penguinmoose/knobOS/img/inside.png

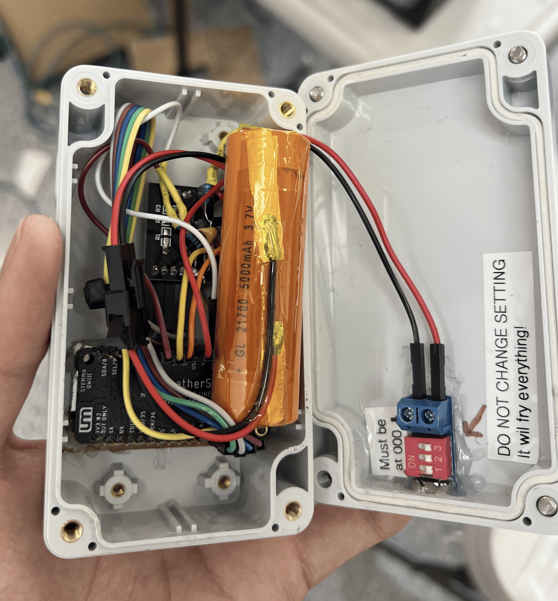
img/inside.png
