penguinmoose/knobOS/img/KnobOS.png

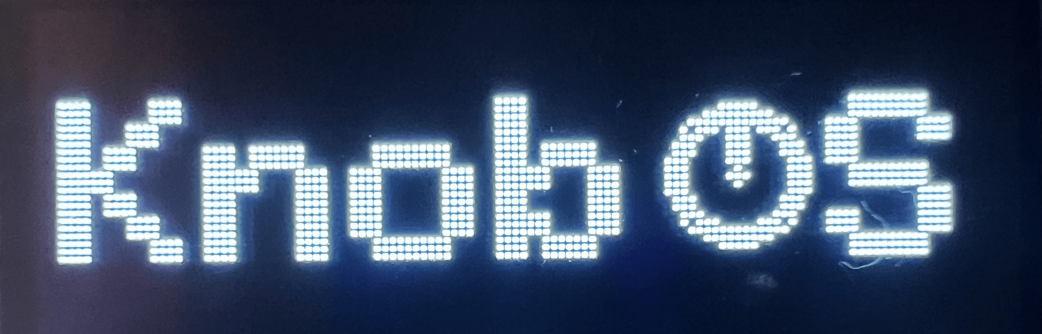
img/KnobOS.png
