penguinmoose/knobOS/img/neopixel-mounting.png

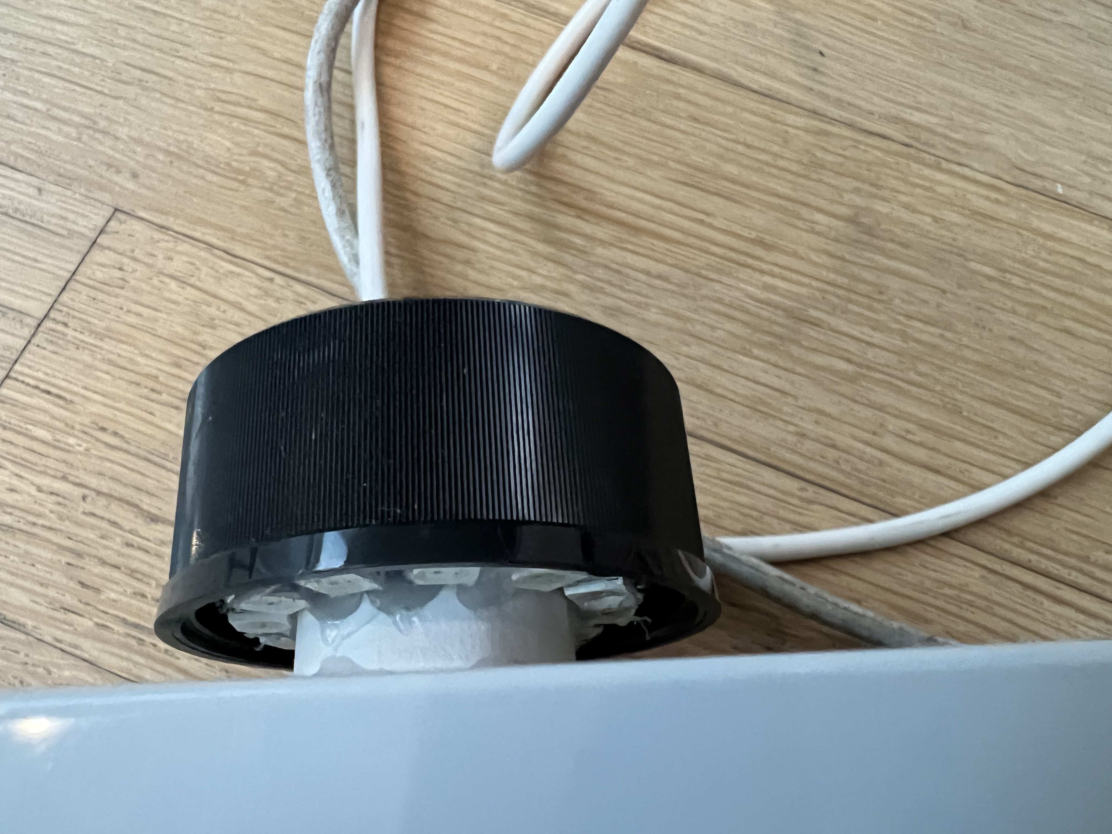
img/neopixel-mounting.png
