penguinmoose/knobOS/knob_os.ino

/* ============================================================================
 *  KNOB OS  --  Unexpected Maker FeatherS2 (ESP32-S2)
 *  + Adafruit 128x64 OLED FeatherWing (SH1107), mounted upside down
 *  + rotary encoder with push-switch (EC11-style)
 *
 *  Home -> Mixer Control
 *       -> Settings -> System Settings
 *                   -> Encoder  -> Encoder Test / Configuration
 *                   -> Wi-Fi    -> Scan / Manual input / Wi-Fi info
 *                   -> Mixer    -> IP, model, tuning
 *                   -> Speaker  -> Scan / Manual IP / Speaker info
 *
 *  BOARD: "UM FeatherS2"  (NOT the Adafruit ESP32-S2 Feather)
 *  LIBS:  Adafruit SH110X, Adafruit GFX, NeoPixel
 * ==========================================================================*/

/* ===========================================================================
 *  KNOB OS  --  version 10.6                        (changelog in CHANGELOG.md)
 *
 *  Major version = a new mini-app or a new subsystem.
 *  Minor version = tweaks, bug fixes, UI work.
 * ========================================================================= */
#define KNOB_OS_VERSION "10.6"

#include <WiFi.h>
#include <WiFiUdp.h>
#include <HTTPClient.h>
#include <stdarg.h>
#include <WiFiClientSecure.h>
#include <WebServer.h>
#include <Wire.h>
#include <Preferences.h>
#include <Adafruit_GFX.h>
#include <Adafruit_SH110X.h>
#include <Adafruit_NeoPixel.h>
#include <esp_sleep.h>
#include <driver/gpio.h>
#include <driver/rtc_io.h>
#include <esp_heap_caps.h>
#include <mbedtls/platform.h>
// Lets npRmtOk() ask whether the NeoPixel pin is still an RMT channel rather
// than trusting a flag; pinMode() elsewhere silently takes it away.
#include <esp32-hal-periman.h>

/* ###########################################################################
 * #                      FORWARD TYPE DECLARATIONS                          #
 * #                                                                         #
 * #  These MUST stay above the first function definition. The Arduino .ino  #
 * #  preprocessor injects auto-generated prototypes just before the first   #
 * #  function, so any type used in a signature has to be declared up here.  #
 * ######################################################################### */

enum Glyph { G_NONE, G_UP, G_DOWN, G_LEFT, G_RIGHT, G_SELECT, G_SELECT_OPEN,
             G_PLAY, G_PAUSE, G_NEXT, G_PREV, G_SPEAKER, G_MUTED, G_SUN,
             G_BACK, G_CHECK_ON, G_CHECK_OFF };

enum BtnId { B_C = 0, B_B = 1, B_A = 2, B_ENC = 3, B_COUNT = 4 };
enum BtnEv { EV_PRESS, EV_REPEAT };

struct App {
  const char *name;
  void (*drawIcon)(int x, int y, int s);
  void (*onEnter)();
  void (*onExit)();
  void (*tick)();
  void (*draw)();
  void (*onButton)(BtnId b, BtnEv e);
  void (*onKnob)(int steps);
  void (*launch)();     // optional prerequisite gate, used instead of a push
  bool (*onBack)();     // return true if the app consumed the back gesture
};

/* Config row kinds. C_LINK/C_ACT are navigation; the rest are editable values.
 * C_CHECK is a bool that toggles on select instead of opening an edit mode --
 * for independent options that are not a choice between alternatives, where a
 * dropdown of two would misrepresent the relationship. */
enum CfgType { C_LINK, C_ACT, C_INT, C_BOOL, C_ENUM, C_INFO, C_CHECK };

struct CfgItem {
  const char *label;
  uint8_t type;
  int32_t *val;
  int32_t lo, hi, step;
  const char *const *opts;
  uint8_t nopts;
  const App *target;
  void (*action)();
  void (*fmt)(char *b, size_t n);   // custom value text, overrides default
  const char *unit;
  /* Both optional and both added after the fact, so they sit at the end: the
   * item tables are positional aggregate initialisers and every existing row
   * leaves these null. */
  const char *(*dynLabel)();        // runtime label, overrides `label`
  bool (*visible)();                // row is hidden while this returns false
};

struct CfgPage {
  const char *title;
  const CfgItem *items;
  uint8_t n;
  uint8_t sel;            // mutable: survives navigating into a submenu
  bool editing;
  const char *(*dynTitle)();
};

struct NvKey { const char *k; int32_t *v; int32_t def; };

// The addresses a single Wi-Fi network carries. Declared up here with the
// other types because the .ino preprocessor puts function prototypes above
// everything, and one of them takes this by reference.
struct NetIps { int32_t mixer; int32_t spk; };

struct TextReq {
  const char *title;
  char *buf;
  uint8_t cap;
  void (*onDone)();
};

/* Each CfgPage repeats its row count as a literal, and forgetting to bump it
 * on adding a row silently hides that row -- a mistake this project has made
 * more than once. Every page declaration is followed by a static_assert that
 * ties the literal to the array, so the next one fails to build instead. */

/* ---- item construction macros (aggregate init must be positional) ------- */
#define ITEM_LINK(l,a)            { l, C_LINK, nullptr,0,0,0, nullptr,0, &a, nullptr, nullptr, nullptr }
#define ITEM_LINKF(l,a,f)         { l, C_LINK, nullptr,0,0,0, nullptr,0, &a, nullptr, f, nullptr }
#define ITEM_ACT(l,fn)            { l, C_ACT,  nullptr,0,0,0, nullptr,0, nullptr, fn, nullptr, nullptr }
#define ITEM_INT(l,v,lo,hi,st,u)  { l, C_INT,  &(v), lo,hi,st, nullptr,0, nullptr,nullptr,nullptr, u }
#define ITEM_BOOL(l,v)            { l, C_BOOL, &(v), 0,1,1, nullptr,0, nullptr,nullptr,nullptr,nullptr }
#define ITEM_ENUM(l,v,o)          { l, C_ENUM, &(v), 0,(int32_t)(sizeof(o)/sizeof(o[0]))-1,1, o,(uint8_t)(sizeof(o)/sizeof(o[0])), nullptr,nullptr,nullptr,nullptr }
#define ITEM_INFO(l,f)            { l, C_INFO, nullptr,0,0,0, nullptr,0, nullptr,nullptr, f, nullptr }
#define ITEM_CHECK(l,v)           { l, C_CHECK,&(v), 0,1,1, nullptr,0, nullptr,nullptr,nullptr,nullptr }
#define ITEM_LINKD(l,a,lf)        { l, C_LINK, nullptr,0,0,0, nullptr,0, &a, nullptr, nullptr, nullptr, lf }
#define ITEM_LINKX(l,a,vis)       { l, C_LINK, nullptr,0,0,0, nullptr,0, &a, nullptr, nullptr, nullptr, nullptr, vis }

/* ###########################################################################
 * #                        FIXED HARDWARE CONFIG                            #
 * #        (things that describe the board, not user preferences)           #
 * ######################################################################### */

/* IP-entry screen state. Declared this early because mixerLaunch, far below,
 * arms the Demo button before the editor's own globals would appear. */
// Defined with the button helpers; used by screens declared before them.
static bool btnSelect(BtnId b);

static bool gIpAllowDemo = false;   // Demo button only offered for the mixer
static int  ipField = 0;            // 0 digits, 1 Demo, 2 Clear
static void (*gIpDemo)() = nullptr;
/* Called whenever the value is written, by either route. Commit and Clear
 * both change the address, so a caller that mirrors it somewhere else has to
 * hear about both -- otherwise clearing an address looks like it worked and
 * comes back on the next lookup. */
static void (*gIpApply)() = nullptr;

/* Rotary encoder. Works with a bare EC11 or with a KY-040 style breakout.
 *
 *   KY-040 pin   ->  here
 *   -----------      ----
 *   CLK          ->  PIN_ENC_A
 *   DT           ->  PIN_ENC_B
 *   SW           ->  PIN_ENC_SW
 *   +            ->  3V3  ** NOT 5V **
 *   GND          ->  GND
 *
 * The + pin may also be left unconnected: every line below is configured
 * INPUT_PULLUP, and the encoder's common contact goes to GND either way. The
 * module's own pull-ups then simply sit unused. Board pull-ups in parallel
 * with the internal ones are harmless -- the result is just a stiffer pull-up.
 *
 * Note some KY-040 clones leave the SW pull-up resistor unpopulated; the
 * internal pull-up covers that case, so SW works regardless.
 *
 * Pin choices worth knowing about:
 *   17/18 are the two DAC outputs. Nothing here uses the DAC, so they are
 *   free -- but if audio output is ever wanted, move CLK/DT elsewhere first.
 *   0 is the BOOT strapping pin. It must be HIGH at reset to boot normally,
 *   which it is: the encoder switch is open when nobody is pressing it and
 *   the internal pull-up holds it high. Holding the shaft button down while
 *   resetting will drop the board into the ROM bootloader instead of running
 *   the sketch -- harmless, and occasionally useful for flashing. */
static const int PIN_ENC_A  = 18;   // CLK  (also DAC2 -- see note below)
static const int PIN_ENC_B  = 17;   // DT   (also DAC1)
static const int PIN_ENC_SW = 0;    // SW   (also the BOOT button)

/* NeoPixel ring, 12 pixels. Pixel 0 sits at 6 o'clock and the index advances
 * clockwise, so a level reads as a gauge sweeping up and around.
 *
 * Wire V+ to BAT, not 3V3: the ring can pull far more than the regulator is
 * meant to source. A 3.3V data line is fine at battery voltage because the
 * WS2812 logic-high threshold is 0.7 x VDD -- about 2.6V at 3.7V, which 3.3V
 * clears easily. */

/* Battery sensing.
 *
 * The plain FeatherS2 has NO on-board battery divider -- unlike the FeatherS2
 * Neo (IO2) and the FeatherS3 (GPIO2), the original board's FAQ states there
 * is no built-in way to read VBAT. So this expects an external divider from
 * BAT to PIN_VBAT, same idea as the 5V sense. Two equal resistors (e.g. two
 * 100k) give a ratio of 2.00; set Batt Ratio to match whatever you fit.
 *
 * PIN_VCHG is the 5V-present sense: a 5.1k:10k divider from the 5V pin gives
 * 5.0 * 10/15.1 = 3.31V, a safe logic high, and 0V when USB is absent. It is
 * an RTC GPIO, so it can also wake the board from deep sleep when a charger
 * is connected. */
static const int PIN_VBAT  = 3;     // external divider from BAT
static const int PIN_VCHG  = 10;    // 5V present, via 5.1k:10k
static const int PIN_NEO   = 7;
static const int NEO_N     = 12;
static const int PIN_BTN_A = 1;    // bottom
static const int PIN_BTN_B = 38;   // middle
static const int PIN_BTN_C = 33;   // top

static const uint8_t OLED_ADDR = 0x3C;
static const int I2C_SDA = 8;
static const int I2C_SCL = 9;

static const int SCREEN_W  = 128;
static const int SCREEN_H  = 64;
static const int CONTENT_W_NARROW = 110;   // leaves room for the label column
static const int CONTENT_W_WIDE   = 126;   // no labels: full width, 2px margin
static int CONTENT_W = CONTENT_W_NARROW;   // reset every frame by loop()
static const int DIVIDER_X = 112;   // nudged right; UI spacing unchanged
static const int LABEL_CX  = 121;          // glyphs span 117..125, 2px margin
// Column geometry: content 0..109, gap 110, divider 111, gap 112..116,
// glyphs 117..125, keep-clear 126..127. The divider-to-glyph gap stays at
// 5px as before; the whole column simply moved right by 3.
static const int LABEL_CY_C = 8, LABEL_CY_B = 32, LABEL_CY_A = 56;

static const int ROW_W    = 106;           // menu row width (scrollbar to right)
static const int ROW_H    = 12;
static const int ROW_TOP  = 14;
static const int ROWS_VIS = 4;
static const int SCROLL_X = 107;

static const uint32_t COMBO_MS   = 18;   // non-chord buttons: debounce only
/* Shortest press that counts as a tap. A release inside the defer window is
 * dispatched at once so a quick tap is not lost, but a contact bounce looks
 * exactly like one -- and dispatching on it delivers the press twice, once
 * there and again when the button settles and the timer expires. A human tap
 * is tens of milliseconds; a bounce is one or two. */
static const uint32_t TAP_MIN_MS = 6;
static const uint32_t DISPLAY_MS = 50;
// Quadrature transitions per mechanical detent on a typical EC11.
static const int ENC_DEFAULT_DIV = 4;

// Protocol timings that have no reason to be user-visible.
static const uint32_t XREMOTE_MS = 4000;
static const uint32_t METER_MS   = 4000;
static const uint32_t RESYNC_MS  = 15000;
static const uint32_t SEND_MIN_MS = 50;
static const float    METER_FLOOR_DB = -60.0f;
static const uint32_t PEAK_HOLD_MS   = 1200;

static const uint32_t WIFI_TIMEOUT_MS = 20000;
static const int      MAX_SAVED_NETS  = 10;

/* ###########################################################################
 * #                    USER SETTINGS  (persisted in NVS)                    #
 * ######################################################################### */

// ---- System --------------------------------------------------------------
static int32_t sysKnobEdit   = 1;   // 0 = edits when merely selected, 1 = only when opened
static int32_t sysStartup    = 0;   // 0 Home, 1 Last app, 2 Last screen
static int32_t sysBackAct    = 0;   // 0 A+B, 1 B+C, 2 A+C, 3 A+B+C
static int32_t sysKnobInvert = 0;
static int32_t sysRepeatDly  = 450;
static int32_t sysRepeatRate = 110;
static int32_t sysComboMs    = 150;  // how long a chord member waits
static int32_t sysStuckSec   = 10;   // ignore a button held this long, 0 = off
static int32_t sysBright     = 200;
static int32_t sysFlip       = 1;   // 1 = rotation 3 (wing mounted inverted)

// ---- Encoder -------------------------------------------------------------
static int32_t encCfgDiv      = ENC_DEFAULT_DIV;  // transitions per detent
static int32_t encCfgInvert   = 0;    // swap if clockwise counts down
static int32_t encCfgAccel    = 1;    // 1 = off, else max multiplier
static int32_t encCfgAccelMs  = 40;   // detents faster than this accelerate
static int32_t encCfgHoldMs   = 2000; // shaft-button hold threshold

// ---- NeoPixel ------------------------------------------------------------
static int32_t npEnable    = 1;
static int32_t npBright    = 60;    // master brightness, applied in software
static int32_t npSmooth    = 1;     // fractional last pixel
static int32_t npOrigin    = 0;     // which physical pixel is the scale start
static int32_t npReverse   = 0;     // flip sweep direction
static int32_t npStep      = 10;    // colour editor coarse step

static int32_t npMxMode    = 1;     // 0 off, 1 fader, 2 meter, 3 auto
/* Auto mode: meter by default, fader when one of these says so. Two
 * independent conditions rather than a choice between them, since wanting the
 * fader while turning and wanting it on a silent channel are unrelated
 * reasons and either, both or neither is a sensible setting. */
static int32_t npMxAutoTurn  = 1;   // show the fader just after a turn
static int32_t npMxAutoQuiet = 1;   // show the fader while nothing is playing
static int32_t npMxAutoHold  = 20;  // how long the turn lasts, x100ms
static int32_t npMxAutoQuiet0 = 10; // silence must last this long, x100ms
static int32_t npMxFadCol  = 0x0080FF;
static int32_t npMxRbCol   = 0xC040FF;
static int32_t npMxZones   = 3;
static int32_t npMxZ1      = 0x00FF00;
static int32_t npMxZ2      = 0xFFA000;
static int32_t npMxZ3      = 0xFF0000;
static int32_t npMxZ4      = 0xFF00FF;
static int32_t npMxT2      = 65;    // % of scale where zone 2 starts
static int32_t npMxT3      = 88;
static int32_t npMxT4      = 97;
static int32_t npMxClip    = 1;     // 0 off, 1 no dim, 2 no dim + full bright
static int32_t npMxEnds    = 1;     // mark 0% / 100% on the fader display
static int32_t npMxWarnCol = 0xFF0000;

static int32_t npSpMode    = 1;     // 0 off, 1 auto, 2 volume, 3 progress
static int32_t npSpCol     = 0x00A0FF;
static int32_t npSpRbCol   = 0xC040FF;   // while the second scrub rate is held
static int32_t npSpEnds    = 1;
static int32_t npSpWarnCol = 0xFF0000;

// ---- Battery and sleep ---------------------------------------------------
static int32_t batSleepMin  = 5;      // idle minutes before sleeping
static int32_t batSleepMode = 0;      // 0 light (all buttons), 1 deep
static int32_t batRatio     = 200;    // divider ratio x100
static int32_t batMv0       = 3300;   // 0%
static int32_t batMv100     = 4200;   // 100%
static int32_t batWarnHi    = 20;     // first warning
static int32_t batWarnLo    = 10;     // second warning
static int32_t batResume    = 5;      // charge to this before normal operation
static int32_t batShowMixer = 1;      // battery readout on the mixer screen
static int32_t batAvgSec    = 20;     // rolling average window
static int32_t batUpdSec    = 5;      // how often the shown value is refreshed
/* Shaft-button action, chosen per app. Mutually exclusive by construction:
 * one action per app, not a set of overlapping toggles. Mute is bound to a
 * hold rather than a click so it cannot be triggered by accident. */
static int32_t encCfgTextBtn  = 0;    // 0 Caps Lock, 1 Confirm, 2 Off

// ---- Mixer ---------------------------------------------------------------
static int32_t mxCfgModel     = 0;    // 0 M32R/X32, 1 X-Air
static int32_t mxCfgIp        = 0;    // packed IPv4, 0 = not set
static int32_t mxCfgPort      = 10023;
static int32_t mxCfgUserHold  = 600;  // ms
static int32_t mxCfgMeterRate = 2;    // 50ms * this
static int32_t mxCfgEncBtn    = 0;    // 0 Hold+Turn strip, 1 Hold=fine, 2 Click, 3 Off
/* Two independent rates, both in 1/1000 of full fader travel per detent.
 * B is simply the rate used while the shaft button is held -- nothing says
 * it has to be the smaller one, so setting B above A turns the hold into a
 * coarse/fast mode instead of a fine one. */
static int32_t mxCfgRateA     = 10;   // 1.0% per detent
static int32_t mxCfgRateB     = 2;    // 0.2% per detent
static int32_t mxCfgAccelOn   = 1;    // 0 off, 1 rate A, 2 rate B, 3 both
static int32_t mxCfgMeterSm   = 55;   // meter release smoothing, %

// ---- Speaker (Sony Audio Control API) ------------------------------------
static int32_t spCfgIp        = 0;     // packed IPv4, 0 = not set
static int32_t spCfgPort      = 10000;
static int32_t spCfgPollMs    = 500;   // volume poll interval
static int32_t spCfgStateMs   = 2500;  // transport-state poll interval
static int32_t spCfgSendMs    = 120;   // min gap between volume writes
static int32_t spCfgUserHold  = 600;
static int32_t spCfgVolMin    = 0;     // knob maps to [VolMin..VolMax], which
static int32_t spCfgVolMax    = 50;    // is a soft range, not a hard stop
// This soundbar's avContent never sees the Spotify Connect stream, so its
// transport verbs do nothing. Mute is local and works, hence the default.
static int32_t spCfgCenterBtn = 0;     // 0 = Auto, 1 = Mute, 2 = Play/Pause
static int32_t spCfgEncBtn    = 0;     // 0 Play/Pause, 1 Mute (hold), 2 Next, 3 Off
/* Which half of Speaker Control leads.
 *
 * All three end up in the same place once the facts are in; they differ only
 * in what is presumed while the first poll is still in flight, which is the
 * couple of seconds the user actually sees. Speaker default presumes a
 * speaker is there and falls back; Spotify default presumes not and switches
 * up when one answers; Spotify only never asks.
 *
 * With addresses now per network, most of the delay this used to cover is
 * gone anyway: on a network with no speaker address there is nothing to
 * presume about, and the app is in Spotify mode from the first frame. */
static int32_t spCfgMode      = 0;     // 0 speaker first, 1 spotify first, 2 spotify only
/* The row under the title is contested: the album wants it, and a long title
 * wants it as a second line. Automatic gives it to whichever needs it. */
static int32_t spCfgTitle     = 2;     // 0 album, 1 wrap, 2 automatic
static int32_t spCfgTitleOver = 1;     // title too long for two lines:
                                       //   0 one marquee row + album, 1 two rows
static int32_t spCfgScrubA    = 5000;  // ms of track per detent
static int32_t spCfgScrubB    = 30000; // ...while the shaft button is held
/* With a speaker the knob belongs to the volume, so seeking has to be asked
 * for: hold the shaft and turn. It gets a rate of its own rather than
 * borrowing Rate B, because it is the only seek rate available in that mode
 * and so wants to sit between a fine and a coarse one rather than being
 * whichever of those Rate B happens to be. 0 disables it. */
static int32_t spCfgScrubHold = 15000; // shaft held while the knob has volume
static int32_t spCfgScrubAcc  = 1;     // 0 off, 1 rate A, 2 rate B, 3 both
static int32_t spCfgBottom    = 0;     // progress block: 0 show, 1 hide
static int32_t spCfgVolHold   = 4;     // seconds the volume overlay lingers
static int32_t spCfgSyPoll    = 4000;  // Spotify metadata poll interval
static int32_t spCfgTransport = 0;     // 0 = Spotify Web, 1 = Sony local, 2 = off
static int32_t spCfgScroll    = 50;    // marquee speed, ms per pixel step
// Cue/review: hold a transport button to scrub through the track.
static int32_t spCfgSeekHold  = 450;   // hold before scrubbing starts, 0 = off
static int32_t spCfgSeekRate  = 15;    // song-seconds per real second
static int32_t spCfgSeekStep  = 100;   // update granularity, ms
static int32_t spCfgSeekAccel = 60;    // %/s speed growth, 0 = constant
static int32_t spCfgTimeRight = 0;     // 0 = remaining, 1 = total duration

// ---- Persisted navigation ------------------------------------------------
static int32_t navSaved0 = -1, navSaved1 = -1, navSaved2 = -1, navSaved3 = -1;

static const NvKey NVKEYS[] = {
  { "sKnobEdit",  &sysKnobEdit,   1   }, { "sStartup",   &sysStartup,    0   },
  { "sBackAct",   &sysBackAct,    0   }, { "sKnobInv",   &sysKnobInvert, 0   },
  { "sRepDly",    &sysRepeatDly,  450 },
  { "sRepRate",   &sysRepeatRate, 110 }, { "sBright",    &sysBright,     200 },
  { "sCombo",     &sysComboMs,    150 }, { "sStuck", &sysStuckSec,  10 },
  { "sFlip",      &sysFlip,       1   },
  { "eDiv",       &encCfgDiv,     ENC_DEFAULT_DIV }, { "eInv", &encCfgInvert, 0 },
  { "eAcc",       &encCfgAccel,   1   }, { "eAccMs",     &encCfgAccelMs, 40  },
  { "eHold",      &encCfgHoldMs,  2000},
  { "npEn",  &npEnable, 1 },      { "npBri",  &npBright, 60 },
  { "npSm",  &npSmooth, 1 },      { "npOrg",  &npOrigin, 0 },
  { "npRev", &npReverse, 0 },     { "npStp",  &npStep,  10 },
  { "npMxM", &npMxMode, 1 },      { "npMxF",  &npMxFadCol, 0x0080FF },
  { "npMxB", &npMxRbCol, 0xC040FF }, { "npMxN", &npMxZones, 3 },
  { "npMxZ1",&npMxZ1, 0x00FF00 }, { "npMxZ2", &npMxZ2, 0xFFA000 },
  { "npMxZ3",&npMxZ3, 0xFF0000 }, { "npMxZ4", &npMxZ4, 0xFF00FF },
  { "npMxT2",&npMxT2, 65 },       { "npMxT3", &npMxT3, 88 },
  { "npMxT4",&npMxT4, 97 },       { "npMxC",  &npMxClip, 1 },
  { "npMxE", &npMxEnds, 1 },      { "npMxW",  &npMxWarnCol, 0xFF0000 },
  { "npMxAT",&npMxAutoTurn, 1 },  { "npMxAQ", &npMxAutoQuiet, 1 },
  { "npMxAH",&npMxAutoHold, 20 }, { "npMxAQD",&npMxAutoQuiet0, 10 },
  { "npSpM", &npSpMode, 1 },      { "npSpC",  &npSpCol, 0x00A0FF },
  { "npSpE", &npSpEnds, 1 },      { "npSpW",  &npSpWarnCol, 0xFF0000 },
  { "npSpB", &npSpRbCol, 0xC040FF },
  { "btSlp", &batSleepMin, 5 },   { "btMode", &batSleepMode, 0 },
  { "btRat", &batRatio, 200 },    { "btMv0",  &batMv0, 3300 },
  { "btMv1", &batMv100, 4200 },   { "btWHi",  &batWarnHi, 20 },
  { "btWLo", &batWarnLo, 10 },    { "btRes",  &batResume, 5 },
  { "btAvg", &batAvgSec, 20 },    { "btUpd",  &batUpdSec, 5 },
  { "btMxS", &batShowMixer, 1 },
  { "mModel",     &mxCfgModel,    0   }, { "mIp",        &mxCfgIp,       0   },
  { "mPort",      &mxCfgPort,     10023}, { "mUserHold",  &mxCfgUserHold, 600 },
  { "mMeterRate", &mxCfgMeterRate,2   }, { "mEncBtn", &mxCfgEncBtn, 0 },
  { "mRateA",     &mxCfgRateA,    10  }, { "mRateB",  &mxCfgRateB,   2 },
  { "mAccelOn",   &mxCfgAccelOn,  1   }, { "mMtrSm", &mxCfgMeterSm, 55 },
  { "pIp",  &spCfgIp,   0    }, { "pPort", &spCfgPort,  10000 },
  { "pPoll",&spCfgPollMs,500  }, { "pState",&spCfgStateMs,2500 },
  { "pSend",&spCfgSendMs,120  }, { "pHold", &spCfgUserHold,600 },
  { "pVMin",&spCfgVolMin,  0  }, { "pVMax", &spCfgVolMax,  50  },
  { "pCtr", &spCfgCenterBtn, 0 }, { "pBot",  &spCfgBottom,    0 },
  { "pEnc", &spCfgEncBtn,    0 }, { "eText", &encCfgTextBtn,  0 },
  { "pVHold",&spCfgVolHold,  4 }, { "pSyP",  &spCfgSyPoll, 4000 },
  { "pTrans",&spCfgTransport,0 }, { "pScrl", &spCfgScroll,   55 },
  { "kHold", &spCfgSeekHold,450 }, { "kRate", &spCfgSeekRate, 15 },
  { "kStep", &spCfgSeekStep,100 }, { "kAccel",&spCfgSeekAccel,60 },
  { "kTimeR",&spCfgTimeRight, 0 },
  { "pMode", &spCfgMode, 0 },     { "kScrA", &spCfgScrubA, 5000 },
  { "pTitle",&spCfgTitle, 2 },    { "pTitleOv", &spCfgTitleOver, 1 },
  { "kScrB", &spCfgScrubB, 30000 }, { "kScrAcc", &spCfgScrubAcc, 1 },
  { "kScrH", &spCfgScrubHold, 15000 },
  { "nav0", &navSaved0, -1 }, { "nav1", &navSaved1, -1 },
  { "nav2", &navSaved2, -1 }, { "nav3", &navSaved3, -1 },
};
static const int NVKEY_N = sizeof(NVKEYS) / sizeof(NVKEYS[0]);

static char wifiSsid[33] = "";
static char wifiPass[65] = "";
static char spName[28]   = "";     // soundbar friendlyName from discovery
static char syClientId[64] = "";
static char sySecret[64]   = "";
char syRefresh[220] = "";   // long-lived; access tokens live in RAM

Preferences prefs;
static bool     nvDirty = false;
static uint32_t nvDirtyMs = 0;

static inline bool elapsed(uint32_t since, uint32_t ms) {
  return (uint32_t)(millis() - since) >= ms;
}

/* Every HTTP call in this firmware blocks, and a blocking call in loop()
 * freezes the knob, the display and the buttons alike. The ESP32-S2 is single
 * core, but FreeRTOS still preempts, and a socket wait yields the CPU, so
 * moving the network work into its own task keeps the UI at full frame rate.
 * The UI only ever sets these flags; netTask does the talking. */
/* Two locks, not one.
 *
 * A single lock meant a Sony request had to wait out whatever Spotify was
 * doing. A TLS handshake or a stalled connect can hold it for seconds, so the
 * speaker's polls timed out on the lock itself and the link looked dead --
 * while the mixer, which talks UDP straight from the UI task and touches
 * neither, carried on working. They use separate client objects, so there was
 * never a reason to serialise them against each other. */
static SemaphoreHandle_t netMutex = nullptr;   // Sony / plain HTTP
static SemaphoreHandle_t syMutex  = nullptr;   // Spotify / TLS
static volatile int      netVolWrite = -1;    // queued volume level
static volatile int      netVolRetry = 0;     // attempts left for that write
/* Two queues, because they belong to two tasks now. netCmd is the LAN side
 * (Sony), syCmd the cloud side (Spotify). */
static volatile uint8_t  netCmd = 0;   // 1 sony next 2 sony prev 3 sony pp 4 mute
static volatile uint8_t  syCmd  = 0;   // 1 next 2 prev 5 play 6 pause 7 seek
static volatile int      netSeekMs = 0;
static volatile bool     syCmdPending = false;   // a Spotify command is in flight
static volatile uint32_t syCmdMs = 0;

// Declared beside the flags so every caller sees it directly.
static void syMarkPending() {
  if (spCfgTransport != 0) return;      // only Spotify commands show this
  syCmdPending = true;
  syCmdMs = millis();
}
static bool syPendingNow() {
  return syCmdPending && !elapsed(syCmdMs, 6000);
}

static volatile bool     netPollVol = false, netPollState = false, netPollSy = false;
static volatile bool     netBusy = false;
static int               netRR = 0;   // round-robin cursor over the polls

// Recursive: syRequest holds it while the 401 path re-enters via the token
// refresh. A plain mutex self-blocks there and wedges the whole task.
static bool netLock() {
  return !netMutex || xSemaphoreTakeRecursive(netMutex, pdMS_TO_TICKS(2500)) == pdTRUE;
}
static void netUnlock() { if (netMutex) xSemaphoreGiveRecursive(netMutex); }

static bool syLock() {
  return !syMutex || xSemaphoreTakeRecursive(syMutex, pdMS_TO_TICKS(15000)) == pdTRUE;
}
static void syUnlock() { if (syMutex) xSemaphoreGiveRecursive(syMutex); }

static void nvLoad() {
  prefs.begin("knobos", true);
  for (int i = 0; i < NVKEY_N; i++)
    *NVKEYS[i].v = prefs.getInt(NVKEYS[i].k, NVKEYS[i].def);
  prefs.getString("wSsid", wifiSsid, sizeof(wifiSsid));
  prefs.getString("wPass", wifiPass, sizeof(wifiPass));
  prefs.getString("spName", spName, sizeof(spName));
  prefs.getString("syId", syClientId, sizeof(syClientId));
  prefs.getString("sySec", sySecret, sizeof(sySecret));
  prefs.getString("syRef", syRefresh, sizeof(syRefresh));
  prefs.end();
}

static void nvFlush() {
  prefs.begin("knobos", false);
  for (int i = 0; i < NVKEY_N; i++) prefs.putInt(NVKEYS[i].k, *NVKEYS[i].v);
  prefs.putString("wSsid", wifiSsid);
  prefs.putString("wPass", wifiPass);
  prefs.putString("spName", spName);
  prefs.putString("syId", syClientId);
  prefs.putString("sySec", sySecret);
  prefs.putString("syRef", syRefresh);
  prefs.end();
  nvDirty = false;
}

// Debounced so a knob sweep across a value doesn't hammer the flash.
static void nvTouch() { nvDirty = true; nvDirtyMs = millis(); }
static void nvService() { if (nvDirty && elapsed(nvDirtyMs, 1500)) nvFlush(); }

static void nvFactoryReset() {
  prefs.begin("knobos", false);
  prefs.clear();
  prefs.end();
  ESP.restart();
}

/* ---- saved network list (unique by SSID, most recent first) -------------- */
static int nvNetCount() {
  prefs.begin("knobos", true);
  int n = prefs.getInt("nNet", 0);
  prefs.end();
  return constrain(n, 0, MAX_SAVED_NETS);
}

static void nvNetGet(int i, char *ssid, size_t sn, char *pass, size_t pn) {
  char ks[8], kp[8];
  snprintf(ks, sizeof(ks), "ns%d", i);
  snprintf(kp, sizeof(kp), "np%d", i);
  prefs.begin("knobos", true);
  prefs.getString(ks, ssid, sn);
  if (pass) prefs.getString(kp, pass, pn);
  prefs.end();
}

/* ---- device addresses per network ----------------------------------------
 *
 * A console lives on one network, and so does a soundbar. Storing one address
 * each meant carrying a venue's mixer IP onto the home network, and the home
 * soundbar's IP everywhere else, where they point at nothing but still read
 * as configured. The mixer app opened, drew a fader and sent OSC into the
 * void; the speaker app offered a volume bar for several seconds before the
 * silence was long enough to prove there was nothing there. Keying both by
 * SSID makes "no mixer here" and "no speaker here" states the device can
 * simply be in, and know instantly.
 *
 * Keyed by SSID rather than by an index into the saved-network list, because
 * that list reorders itself on every connect.
 *
 * mnVer records which fields have been populated from the older single-value
 * settings: 1 = mixer (v10.0), 2 = speaker (v10.4). */
static int nvNetIpsCount() {
  prefs.begin("knobos", true);
  int n = prefs.getInt("mnN", 0);
  prefs.end();
  return constrain(n, 0, MAX_SAVED_NETS);
}

static void nvNetIpsGet(int i, char *ssid, size_t sn, NetIps *out) {
  char ks[8], ki[8], kp[8];
  snprintf(ks, sizeof(ks), "mns%d", i);
  snprintf(ki, sizeof(ki), "mni%d", i);
  snprintf(kp, sizeof(kp), "mnp%d", i);
  prefs.begin("knobos", true);
  if (ssid) prefs.getString(ks, ssid, sn);
  if (out) {
    out->mixer = prefs.getInt(ki, 0);
    out->spk   = prefs.getInt(kp, 0);
  }
  prefs.end();
}

static bool nvNetIpsFind(const char *ssid, NetIps *out) {
  if (out) { out->mixer = 0; out->spk = 0; }
  if (!ssid || !ssid[0]) return false;
  int n = nvNetIpsCount();
  for (int i = 0; i < n; i++) {
    char es[33];
    NetIps v = { 0, 0 };
    es[0] = 0;
    nvNetIpsGet(i, es, sizeof(es), &v);
    if (es[0] && !strcmp(es, ssid)) { if (out) *out = v; return true; }
  }
  return false;
}

/* An address of 0 means "no such device on this network", which is a real
 * answer and worth storing -- otherwise clearing one would silently fall back
 * to whatever the previous single global value happened to be. */
static void nvNetIpsSet(const char *ssid, const NetIps &val) {
  if (!ssid || !ssid[0]) return;
  char s[MAX_SAVED_NETS][33];
  NetIps v[MAX_SAVED_NETS];
  int n = nvNetIpsCount(), out = 0;

  strncpy(s[0], ssid, 32); s[0][32] = 0;
  v[0] = val;
  out = 1;
  for (int i = 0; i < n && out < MAX_SAVED_NETS; i++) {
    char es[33];
    NetIps ev = { 0, 0 };
    es[0] = 0;
    nvNetIpsGet(i, es, sizeof(es), &ev);
    if (!es[0] || !strcmp(es, ssid)) continue;      // dedupe
    strncpy(s[out], es, 32); s[out][32] = 0;
    v[out] = ev;
    out++;
  }

  prefs.begin("knobos", false);
  prefs.putInt("mnN", out);
  for (int i = 0; i < out; i++) {
    char ks[8], ki[8], kp[8];
    snprintf(ks, sizeof(ks), "mns%d", i);
    snprintf(ki, sizeof(ki), "mni%d", i);
    snprintf(kp, sizeof(kp), "mnp%d", i);
    prefs.putString(ks, s[i]);
    prefs.putInt(ki, v[i].mixer);
    prefs.putInt(kp, v[i].spk);
  }
  prefs.end();
}

// Read-modify-write, so setting one address never blanks the other.
static void nvNetSetMixer(const char *ssid, int32_t ip) {
  NetIps v = { 0, 0 };
  nvNetIpsFind(ssid, &v);
  v.mixer = ip;
  nvNetIpsSet(ssid, v);
}
static void nvNetSetSpk(const char *ssid, int32_t ip) {
  NetIps v = { 0, 0 };
  nvNetIpsFind(ssid, &v);
  v.spk = ip;
  nvNetIpsSet(ssid, v);
}

static void nvNetRemember(const char *ssid, const char *pass) {
  if (!ssid[0]) return;
  char s[MAX_SAVED_NETS][33], p[MAX_SAVED_NETS][65];
  int n = nvNetCount(), out = 0;

  strncpy(s[0], ssid, 32); s[0][32] = 0;
  strncpy(p[0], pass, 64); p[0][64] = 0;
  out = 1;
  for (int i = 0; i < n && out < MAX_SAVED_NETS; i++) {
    char es[33], ep[65];
    es[0] = ep[0] = 0;
    nvNetGet(i, es, sizeof(es), ep, sizeof(ep));
    if (!es[0] || !strcmp(es, ssid)) continue;      // dedupe
    strncpy(s[out], es, 32); s[out][32] = 0;
    strncpy(p[out], ep, 64); p[out][64] = 0;
    out++;
  }

  prefs.begin("knobos", false);
  prefs.putInt("nNet", out);
  for (int i = 0; i < out; i++) {
    char ks[8], kp[8];
    snprintf(ks, sizeof(ks), "ns%d", i);
    snprintf(kp, sizeof(kp), "np%d", i);
    prefs.putString(ks, s[i]);
    prefs.putString(kp, p[i]);
  }
  prefs.end();
}

/* ###########################################################################
 * #                    DISPLAY / UI PRIMITIVES                              #
 * ######################################################################### */

Adafruit_SH1107 display = Adafruit_SH1107(64, 128, &Wire);
WiFiUDP udp;

static uint32_t gFrame = 0;   // rendered-frame counter, drives the marquee

static int textW(const char *s) { return (int)strlen(s) * 6; }

// Screens that draw no button-label column can claim the whole panel.
static void uiWide() { CONTENT_W = CONTENT_W_WIDE; }
static int  uiCols() { return CONTENT_W / 6; }

static void printClipped(int x, int y, const char *s, int maxPx) {
  int maxChars = maxPx / 6;
  if (maxChars < 1) return;
  char buf[40];
  if (maxChars > (int)sizeof(buf) - 1) maxChars = sizeof(buf) - 1;
  snprintf(buf, sizeof(buf), "%.*s", maxChars, s);
  display.setCursor(x, y);
  display.print(buf);
}

static void drawGlyph(int cx, int cy, Glyph g, uint16_t col = SH110X_WHITE) {
  const int a = 3, b = 2;
  switch (g) {
    case G_UP:
      display.drawLine(cx - a, cy + b, cx, cy - b, col);
      display.drawLine(cx, cy - b, cx + a, cy + b, col);
      break;
    case G_DOWN:
      display.drawLine(cx - a, cy - b, cx, cy + b, col);
      display.drawLine(cx, cy + b, cx + a, cy - b, col);
      break;
    case G_LEFT:
      display.drawLine(cx + b, cy - a, cx - b, cy, col);
      display.drawLine(cx - b, cy, cx + b, cy + a, col);
      break;
    case G_RIGHT:
      display.drawLine(cx - b, cy - a, cx + b, cy, col);
      display.drawLine(cx + b, cy, cx - b, cy + a, col);
      break;
    case G_SELECT:      display.fillCircle(cx, cy, 3, col); break;
    case G_SELECT_OPEN: display.drawCircle(cx, cy, 3, col); break;
    /* A return arrow, not a left chevron. "<" is the same shape this UI uses
     * for "move left", so on a screen where the bottom button leaves rather
     * than moves it read as a direction instead of an action. */
    case G_BACK:
      display.drawFastHLine(cx - 3, cy + 1, 7, col);
      display.drawFastVLine(cx + 3, cy - 3, 5, col);
      display.drawLine(cx - 3, cy + 1, cx, cy - 2, col);
      display.drawLine(cx - 3, cy + 1, cx, cy + 4, col);
      break;
    case G_CHECK_OFF:
      display.drawRect(cx - 4, cy - 4, 9, 9, col);
      break;
    case G_CHECK_ON:
      display.drawRect(cx - 4, cy - 4, 9, 9, col);
      display.drawLine(cx - 2, cy, cx - 1, cy + 2, col);
      display.drawLine(cx - 1, cy + 2, cx + 2, cy - 2, col);
      display.drawLine(cx - 2, cy + 1, cx - 1, cy + 3, col);
      display.drawLine(cx - 1, cy + 3, cx + 2, cy - 1, col);
      break;
    case G_PLAY:
      display.fillTriangle(cx - 3, cy - 4, cx - 3, cy + 4, cx + 4, cy, col);
      break;
    case G_PAUSE:
      display.fillRect(cx - 3, cy - 4, 2, 9, col);
      display.fillRect(cx + 1, cy - 4, 2, 9, col);
      break;
    case G_NEXT:
      display.fillTriangle(cx - 4, cy - 4, cx - 4, cy + 4, cx + 1, cy, col);
      display.fillRect(cx + 2, cy - 4, 2, 9, col);
      break;
    case G_PREV:
      display.fillRect(cx - 4, cy - 4, 2, 9, col);
      display.fillTriangle(cx + 3, cy - 4, cx + 3, cy + 4, cx - 2, cy, col);
      break;
    case G_SUN: {
      display.fillCircle(cx, cy, 2, col);
      for (int a = 0; a < 8; a++) {
        float t = a * PI / 4.0f;
        int x1 = cx + (int)lroundf(cosf(t) * 4), y1 = cy + (int)lroundf(sinf(t) * 4);
        int x2 = cx + (int)lroundf(cosf(t) * 5), y2 = cy + (int)lroundf(sinf(t) * 5);
        display.drawLine(x1, y1, x2, y2, col);
      }
      break;
    }
    case G_SPEAKER:
    case G_MUTED:
      display.fillRect(cx - 4, cy - 2, 3, 5, col);
      display.fillTriangle(cx - 1, cy - 4, cx - 1, cy + 4, cx + 2, cy, col);
      if (g == G_MUTED) display.drawLine(cx - 4, cy + 4, cx + 4, cy - 4, col);
      else { display.drawFastVLine(cx + 4, cy - 2, 5, col); }
      break;
    default: break;
  }
}

static void drawButtonLabels(Glyph c, Glyph b, Glyph a) {
  display.drawFastVLine(DIVIDER_X, 0, SCREEN_H, SH110X_WHITE);
  drawGlyph(LABEL_CX, LABEL_CY_C, c);
  drawGlyph(LABEL_CX, LABEL_CY_B, b);
  drawGlyph(LABEL_CX, LABEL_CY_A, a);
}

static void drawBar(int x, int y, int w, int h, float frac) {
  display.drawRect(x, y, w, h, SH110X_WHITE);
  int f = (int)(constrain(frac, 0.0f, 1.0f) * (w - 2));
  if (f > 0) display.fillRect(x + 1, y + 1, f, h - 2, SH110X_WHITE);
}

static void drawTitle(const char *t) {
  display.setTextSize(1);
  display.setTextColor(SH110X_WHITE);
  printClipped(0, 0, t, CONTENT_W);
  display.drawFastHLine(0, 10, CONTENT_W, SH110X_WHITE);
}

static void drawCentered(int y, const char *s) {
  int x = (CONTENT_W - textW(s)) / 2;
  printClipped(x < 0 ? 0 : x, y, s, CONTENT_W);
}

static void drawScrollbar(int n, int first) {
  if (n <= ROWS_VIS) return;
  int h = ROWS_VIS * ROW_H;
  display.drawRect(SCROLL_X, ROW_TOP, 3, h, SH110X_WHITE);
  int th = max(4, h * ROWS_VIS / n);
  int ty = ROW_TOP + (h - th) * first / (n - ROWS_VIS);
  display.fillRect(SCROLL_X, ty, 3, th, SH110X_WHITE);
}

/* A menu row.
 *   selected + not editing -> whole row inverted
 *   selected + editing     -> row inverted, value re-inverted inside a chip,
 *                             so the field being changed reads as "open"     */
static void drawRow(int y, bool sel, bool editing, const char *label,
                    const char *value, Glyph tail) {
  if (sel) display.fillRect(0, y, ROW_W, ROW_H - 1, SH110X_WHITE);
  uint16_t fg = sel ? SH110X_BLACK : SH110X_WHITE;
  display.setTextColor(fg);

  int vw = value ? textW(value) : 0;
  int tailW = (tail != G_NONE) ? 9 : 0;
  int vx = ROW_W - 3 - vw - tailW;

  printClipped(3, y + 2, label, vx - 5);

  if (value && vw) {
    if (editing) {
      display.fillRect(vx - 2, y, vw + 4, ROW_H - 1, SH110X_BLACK);
      display.setTextColor(SH110X_WHITE);
    }
    display.setCursor(vx, y + 2);
    display.print(value);
    display.setTextColor(fg);
  }
  if (tail != G_NONE) drawGlyph(ROW_W - 6, y + ROW_H / 2 - 1, tail, fg);
  display.setTextColor(SH110X_WHITE);
}

/* ###########################################################################
 * #                       BATTERY AND SLEEP                                 #
 * #                                                                         #
 * #  Wake-source constraint worth knowing: on the ESP32-S2 only GPIO0..21   #
 * #  are RTC-capable, and deep sleep can only be woken by those. Buttons B  #
 * #  (38) and C (33) are outside that range, so they physically cannot wake #
 * #  the chip from deep sleep. Light sleep has no such limit -- any GPIO    #
 * #  can wake it -- at the cost of a few hundred microamps instead of tens. #
 * #  Light is therefore the default, since all four buttons work and the    #
 * #  screen resumes exactly where it was; Deep is offered for long storage. #
 * ######################################################################### */

RTC_DATA_ATTR static int  rtcWokeEmpty = 0;   // slept because the pack was flat
RTC_DATA_ATTR static int  rtcGoHome    = 0;   // slept from the sleep menu

static bool     gExtMalloc = false;   // did a large malloc land in PSRAM?
static volatile bool gSyBusy = false; // a Spotify request is in flight

/* ---- mbedTLS allocator: the actual cause of "connect -1 blk 34xxx" -------
 *
 * Every PSRAM measure since v8.8 was aimed at the wrong pool. The Arduino
 * core ships CONFIG_MBEDTLS_INTERNAL_MEM_ALLOC=y, which pins EVERY mbedTLS
 * allocation to MALLOC_CAP_INTERNAL. So ps_malloc for our own buffers, and
 * heap_caps_malloc_extmem_enable() for the general allocator, could never
 * reach it: mbedTLS does not use the general allocator at all.
 *
 * And it is asking for a lot. CONFIG_MBEDTLS_SSL_MAX_CONTENT_LEN is 16384
 * with CONFIG_MBEDTLS_ASYMMETRIC_CONTENT_LEN switched OFF, so a handshake
 * allocates BOTH record buffers at full size -- roughly 16.5KB each, ~33KB
 * together, and the certificate chain on top of that. ESP.getMaxAllocHeap()
 * reports the largest free INTERNAL block, which is the very pool in
 * question, and on this board it reads 32-38KB. That is why the number in
 * the error message sat just above the guard and the handshake still failed:
 * the first buffer fits, the second only just, and the chain parse does not.
 * A figure that hovers on the boundary is also why this was intermittent for
 * so long and why every timeout, retry and task change moved it slightly.
 *
 * mbedTLS record buffers are never touched by DMA -- lwIP copies into them --
 * so external RAM is a perfectly valid home for them. That is exactly what
 * CONFIG_MBEDTLS_EXTERNAL_MEM_ALLOC does, and since a stock Arduino install
 * cannot change sdkconfig, the same thing is done at runtime here.
 *
 * Only blocks at or above TLS_PS_MIN are moved. Small, frequent crypto
 * allocations stay in fast internal RAM, so this is narrower than the global
 * extmem redirect reverted in v9.7 -- and unlike that one it cannot touch the
 * Wi-Fi driver's DMA buffers, because those never come through mbedTLS. */
static const size_t TLS_PS_MIN = 1024;
static bool gTlsPsram = false;        // mbedTLS allocations redirected to PSRAM

static void *tlsPsCalloc(size_t n, size_t sz) {
  if (sz && n > (SIZE_MAX / sz)) return nullptr;
  if (n * sz >= TLS_PS_MIN) {
    void *p = heap_caps_calloc(n, sz, MALLOC_CAP_SPIRAM | MALLOC_CAP_8BIT);
    if (p) return p;                  // fall through to internal if PSRAM is full
  }
  return heap_caps_calloc(n, sz, MALLOC_CAP_INTERNAL | MALLOC_CAP_8BIT);
}
static void tlsPsFree(void *p) { heap_caps_free(p); }

/* Must run before anything does crypto -- the Wi-Fi supplicant included --
 * so this is called at the very top of setup(). */
static void tlsHeapInit() {
  if (!psramFound()) return;
  gTlsPsram = (mbedtls_platform_set_calloc_free(tlsPsCalloc, tlsPsFree) == 0);
}

/* Modem power save is on by default. It parks the radio between DTIM beacons,
 * which costs little on a strong link but on a weak one turns into dropped
 * packets and long retransmits -- and a TLS handshake is a long chain of
 * small round trips, so it fails where a single tiny LAN request still gets
 * through. That asymmetry is exactly the "speaker works, Spotify does not"
 * pattern at -80 dBm. */
static void wifiTune() {
  /* Power save off is a genuine reliability win on a marginal link. Forcing
   * maximum TX power is not: it raises the current spike during transmit,
   * and on battery a sag mid-handshake looks exactly like a refused
   * connection. It was not set when this last worked, so it is left at the
   * driver's default. */
  WiFi.setSleep(false);
}
static float    batMvEma = -1.0f;
static uint32_t batLastRead = 0;
static uint32_t gLastActivity = 0;
static bool     gWakeGuard = false;   // ignore buttons until all are released
static int      batWarned = 0;        // 0 none, 1 high warning, 2 low warning
static bool     batChargeWait = false;

static bool batCharging() { return digitalRead(PIN_VCHG) == HIGH; }

/* Two separate time constants, because they solve different halves of the
 * jitter. The rolling average smooths ADC and load noise; the latch stops the
 * displayed number twitching even when the average moves slightly. Without
 * the latch a slow average still flickers between two adjacent percentages. */
static const uint32_t BAT_SAMPLE_MS = 250;
static float    batShownMv = -1.0f;
static uint32_t batLastUpd = 0;

static int batMv() {
  if (batMvEma < 0.0f || elapsed(batLastRead, BAT_SAMPLE_MS)) {
    batLastRead = millis();
    uint32_t acc = 0;
    for (int i = 0; i < 8; i++) acc += analogReadMilliVolts(PIN_VBAT);
    float mv = (acc / 8.0f) * ((float)batRatio / 100.0f);
    if (batMvEma < 0.0f) { batMvEma = mv; batShownMv = mv; }
    else {
      // Exponential average whose time constant is the configured window.
      float n = max(1.0f, (float)batAvgSec * 1000.0f / BAT_SAMPLE_MS);
      batMvEma += (mv - batMvEma) / n;
    }
  }
  if (batShownMv < 0.0f || elapsed(batLastUpd, (uint32_t)max((int)batUpdSec, 1) * 1000UL)) {
    batLastUpd = millis();
    batShownMv = batMvEma;
  }
  return (int)lroundf(batShownMv);
}

/* Linear between the configured endpoints. A LiPo's discharge curve is not
 * linear, but the flat middle means any simple mapping is approximate; the
 * endpoints are configurable so the reading can be trimmed to the pack. */
static int batSoc() {
  int span = max(1, (int)(batMv100 - batMv0));
  return constrain((batMv() - (int)batMv0) * 100 / span, 0, 100);
}

static void batNoteActivity() { gLastActivity = millis(); }

/* Battery glyph. Five fill states plus a bolt when 5V is present. */
/* Lightning bolt, drawn to the LEFT of the battery rather than inside it:
 * at scale 1 the body is only 5px tall, and a bolt inked into that is not
 * legible. */
static void drawBolt(int x, int y, int scale) {
  int u = scale;
  display.fillTriangle(x + 3*u, y, x, y + 5*u, x + 3*u, y + 5*u, SH110X_WHITE);
  display.fillTriangle(x + 2*u, y + 9*u, x + 5*u, y + 4*u, x + 2*u, y + 4*u, SH110X_WHITE);
}

static void drawBattery(int x, int y, int soc, int scale) {
  // 14 wide rather than 13: at 13 the first bar sat against the border and
  // read as part of it, so two bars looked like one.
  int w = 14 * scale, h = 7 * scale;
  display.drawRect(x, y, w, h, SH110X_WHITE);
  display.fillRect(x + w, y + 2 * scale, scale, h - 4 * scale, SH110X_WHITE);

  int bars = (soc >= 88) ? 4 : (soc >= 63) ? 3 : (soc >= 38) ? 2 : (soc >= 13) ? 1 : 0;
  for (int i = 0; i < bars; i++)
    display.fillRect(x + 2 * scale + i * 3 * scale, y + scale, 2 * scale,
                     h - 2 * scale, SH110X_WHITE);
  if (!bars && soc > 0)   // nearly empty: a sliver rather than nothing
    display.fillRect(x + 2 * scale, y + scale, scale, h - 2 * scale, SH110X_WHITE);
}

// Icon plus percentage, right-aligned so it sits neatly in a corner.
static void drawBatteryStatus(int rightX, int y, int scale) {
  int soc = batSoc();
  bool chg = batCharging();
  char t[8];
  snprintf(t, sizeof(t), "%d%%", soc);
  int tw = (int)strlen(t) * 6 * scale;
  int bw = 15 * scale;              // body plus the terminal nub
  int boltW = chg ? (6 * scale) : 0;   // 1px tighter to pay for the wider body
  int x = rightX - (boltW + bw + 3 + tw);
  if (chg) drawBolt(x - 1, y - scale, scale);   // 1px left, clears the body
  drawBattery(x + boltW, y, soc, scale);
  display.setTextSize(scale);
  display.setCursor(x + boltW + bw + 3, y);
  display.print(t);
  display.setTextSize(1);
}

/* ---- sleep ------------------------------------------------------------- */
static void sleepPrepare() {
  npClear();
  /* Clearing sends zeros, but once the CPU sleeps GPIO7 stops being driven
   * and a floating WS2812 data line can latch noise into the pixels -- which
   * on a ring powered straight from BAT means it keeps draining. Drive the
   * line low and latch that state so it survives sleep. The short delay lets
   * the clear frame plus its reset gap finish first. */
  delay(5);
  pinMode(PIN_NEO, OUTPUT);
  digitalWrite(PIN_NEO, LOW);
  gpio_hold_en((gpio_num_t)PIN_NEO);
  gpio_deep_sleep_hold_en();
  display.clearDisplay();
  display.display();
  display.oled_command(SH110X_DISPLAYOFF);
}

static void sleepResume() {
  gpio_hold_dis((gpio_num_t)PIN_NEO);
  gpio_deep_sleep_hold_dis();
  display.oled_command(SH110X_DISPLAYON);
  gWakeGuard = true;             // the wake press must not also act
  knobResetSteps();
  batNoteActivity();
}

/* Nothing may be held when sleep begins.
 *
 * Both wake sources are LEVEL triggered, not edge: a button that is still
 * down when the CPU stops is not a press waiting to happen, it is the wake
 * condition already true. Deep sleep waited for the shaft button because that
 * is its only wake pin; light sleep arms all four and waited for none of
 * them, so holding the select button a moment too long woke the device on the
 * instant it slept. The wake guard could not help -- the device was awake and
 * correctly ignoring the button, which is a different problem from never
 * having slept.
 *
 * The cap exists so a genuinely stuck button cannot block sleep forever; it
 * will wake straight back up, which is the honest outcome. */
static void sleepWaitRelease(const int *pins, int n) {
  uint32_t t0 = millis();
  for (;;) {
    bool held = false;
    for (int i = 0; i < n; i++) if (digitalRead(pins[i]) == LOW) held = true;
    if (!held || millis() - t0 > 5000) break;
    delay(10);
  }
  delay(60);                          // let the contact settle
}

static void enterSleep(bool fromMenu, bool forceDeep = false) {
  rtcGoHome = fromMenu ? 1 : 0;
  navSaveNow();
  nvFlush();
  sleepPrepare();

  if (batSleepMode == 0 && !forceDeep) {
    /* Light sleep: every button can wake it because GPIO wake is not limited
     * to RTC pins. Wi-Fi is stopped first, otherwise the radio keeps waking
     * the CPU for beacons and the saving is largely undone. */
    WiFi.disconnect(true);
    WiFi.mode(WIFI_OFF);
    const int pins[4] = { PIN_BTN_A, PIN_BTN_B, PIN_BTN_C, PIN_ENC_SW };
    sleepWaitRelease(pins, 4);        // all four wake it, so all four must be up
    for (int i = 0; i < 4; i++)
      gpio_wakeup_enable((gpio_num_t)pins[i], GPIO_INTR_LOW_LEVEL);
    esp_sleep_enable_gpio_wakeup();
    esp_light_sleep_start();

    WiFi.mode(WIFI_STA);
    if (wifiConfigured()) { WiFi.begin(wifiSsid, wifiPass); wifiTune(); }
    sleepResume();
    if (fromMenu) navHome();
    return;
  }

  /* Deep sleep: ext0 takes a single RTC pin, so the shaft button is the wake
   * key. B and C are not RTC-capable and cannot serve here.
   *
   * Two things have to be right or it wakes immediately. The normal GPIO
   * pull-up is switched off when the digital domain powers down, so the pin
   * floats and reads LOW -- which is exactly the wake condition. The RTC
   * pull-up has to be enabled instead. And the button that selected "Off" is
   * still down at this point, so wait for it to come up first. */
  rtc_gpio_pullup_en((gpio_num_t)PIN_ENC_SW);
  rtc_gpio_pulldown_dis((gpio_num_t)PIN_ENC_SW);
  const int deepPin[1] = { PIN_ENC_SW };
  sleepWaitRelease(deepPin, 1);       // ext0 is the shaft button alone
  esp_sleep_enable_ext0_wakeup((gpio_num_t)PIN_ENC_SW, 0);
  esp_deep_sleep_start();
}

/* Flat battery. Sleep with the charger line as the only wake source.
 *
 * Polling on a timer to re-check the level would spend energy from an already
 * empty pack, and could not change the outcome anyway: nothing but a charger
 * raises the charge. Waking on the charger line costs nothing while asleep
 * and fires exactly when something can actually be done. */
static void enterEmptySleep() {
  rtcWokeEmpty = 1;
  navSaveNow();
  nvFlush();
  sleepPrepare();
  // Same reasoning in reverse: hold the charge-sense line down so a floating
  // input cannot look like "charger connected".
  rtc_gpio_pulldown_en((gpio_num_t)PIN_VCHG);
  rtc_gpio_pullup_dis((gpio_num_t)PIN_VCHG);
  esp_sleep_enable_ext1_wakeup(1ULL << PIN_VCHG, ESP_EXT1_WAKEUP_ANY_HIGH);
  esp_deep_sleep_start();
}

/* ###########################################################################
 * #                        NEOPIXEL RING                                    #
 * #                                                                         #
 * #  A 12-pixel ring used as a gauge. Pixel 0 is at 6 o'clock and the index #
 * #  runs clockwise, so a level sweeps up and around like a dial.           #
 * #                                                                         #
 * #  Brightness is applied in software rather than through the library's    #
 * #  setBrightness(), because the clip indicator has to be able to ignore   #
 * #  the master level entirely -- a clip you might miss is not a clip       #
 * #  indicator.                                                             #
 * ######################################################################### */

static Adafruit_NeoPixel ring(NEO_N, PIN_NEO, NEO_GRB + NEO_KHZ800);
static uint8_t npBuf[NEO_N][3];
static bool    npTouched = false;   // did anything draw this frame?
static bool    npLit = false;       // is anything currently lit?

static inline uint8_t npR(int32_t c) { return (uint8_t)((c >> 16) & 0xFF); }
static inline uint8_t npG(int32_t c) { return (uint8_t)((c >> 8) & 0xFF); }
static inline uint8_t npB(int32_t c) { return (uint8_t)(c & 0xFF); }
static inline int32_t npRGB(int r, int g, int b) {
  return ((int32_t)(r & 0xFF) << 16) | ((int32_t)(g & 0xFF) << 8) | (b & 0xFF);
}

/* ---- claiming the RMT channel ourselves ---------------------------------
 *
 * The ring failing to start on some boots and coming right after a reset is
 * a stuck semaphore inside the library.
 *
 * Adafruit_NeoPixel's ESP-IDF 5 backend takes a mutex around every show().
 * On one path -- rmtInit() failing -- it returns WITHOUT giving that mutex
 * back. Every later show() then times out on it and does nothing, silently,
 * for the rest of the session. A ring that is dead until the next boot is
 * exactly what that produces. (There is a second, quieter one: the mutex is
 * created once from a global constructor and never retried, and if that
 * allocation failed show() would be a no-op forever.)
 *
 * So the channel is claimed here, before the library ever asks for it.
 * rmtInit() returns true immediately when the pin is already a TX channel at
 * the same frequency and block size, so once this succeeds the library's own
 * call becomes a no-op that cannot fail and cannot strand anything. The
 * parameters must match its call exactly (10MHz, one memory block) or it
 * will tear this down and build its own.
 *
 * Re-checked rather than latched: pinMode() detaches the channel through the
 * peripheral manager, and sleepPrepare() parks the data line that way before
 * every sleep. */
static bool     npRmtReady = false;
static uint32_t npRmtTry = 0;

static bool npRmtOk() {
  if (npRmtReady && perimanGetPinBusType(PIN_NEO) == ESP32_BUS_TYPE_RMT_TX)
    return true;
  /* Either it was never claimed or something detached it. Re-claim at once in
   * the second case; rate-limit the first, so hardware that is genuinely
   * refusing is not asked twenty times a second. */
  if (npRmtReady || elapsed(npRmtTry, 500)) {
    npRmtTry = millis();
    npRmtReady = rmtInit(PIN_NEO, RMT_TX_MODE, RMT_MEM_NUM_BLOCKS_1, 10000000);
    return npRmtReady;
  }
  npRmtReady = false;
  return false;
}

static void npBegin() {
  // Release any pad hold left over from a previous deep sleep.
  gpio_deep_sleep_hold_dis();
  gpio_hold_dis((gpio_num_t)PIN_NEO);
  /* Retry the library's own mutex. It is created from a global constructor
   * and never attempted again, so a single failure there would be permanent. */
  espInit();
  ring.begin();                     // pinMode() first: it would detach the RMT
  ring.setBrightness(255);          // scaling is done per pixel below
  /* A few attempts before giving up on the claim, since the boot-time failure
   * this is here to fix is intermittent rather than absolute. npRmtOk() keeps
   * trying afterwards regardless, so a ring that misses its start now comes
   * up on its own instead of waiting for a reset. */
  /* Claimed directly rather than through npRmtOk(), whose rate limit is
   * measured against millis() -- which is still small this early and would
   * refuse the retries. */
  for (int i = 0; i < 5 && !npRmtReady; i++) {
    npRmtReady = rmtInit(PIN_NEO, RMT_TX_MODE, RMT_MEM_NUM_BLOCKS_1, 10000000);
    if (!npRmtReady) delay(20);
  }
  npRmtTry = millis();
  ring.clear();
  if (npRmtReady) ring.show();
  /* If the pixel buffer is null the library's malloc failed and nothing will
   * ever light, which is otherwise indistinguishable from a wiring fault. */
  Serial.printf("[np] pin=%d n=%d buf=%s rmt=%s\n", PIN_NEO, NEO_N,
                ring.getPixels() ? "ok" : "NULL", npRmtReady ? "ok" : "FAIL");
}

static void npFrameStart() { memset(npBuf, 0, sizeof(npBuf)); npTouched = true; }

/* Map a logical scale position onto a physical pixel, honouring the origin
 * offset and direction so the ring can be mounted any way round. */
static int npMap(int i) {
  int n = NEO_N;
  int k = npReverse ? (n - 1 - i) : i;
  k += (int)npOrigin;
  k %= n;
  if (k < 0) k += n;
  return k;
}

// level 0..1 of this pixel's own contribution, colour scaled by it
static void npSet(int i, int32_t col, float level, bool ignoreMaster) {
  if (i < 0 || i >= NEO_N) return;
  level = constrain(level, 0.0f, 1.0f);
  float m = ignoreMaster ? 1.0f : (float)constrain(npBright, 1, 255) / 255.0f;
  float f = level * m;
  int p = npMap(i);
  npBuf[p][0] = (uint8_t)lroundf(npR(col) * f);
  npBuf[p][1] = (uint8_t)lroundf(npG(col) * f);
  npBuf[p][2] = (uint8_t)lroundf(npB(col) * f);
}

/* Push to the ring only when something actually changed, and never faster
 * than the display refresh. show() was previously called on every loop pass
 * -- several hundred times a second -- which achieves nothing visible and
 * keeps the RMT peripheral busy for ~360us each time. */
static uint8_t  npSent[NEO_N][3];
static uint32_t npLastShow = 0;

static void npFrameEnd() {
  if (!npEnable || !npRmtOk()) return;
  bool changed = memcmp(npSent, npBuf, sizeof(npBuf)) != 0;
  if (!changed || !elapsed(npLastShow, DISPLAY_MS)) { npLit = true; return; }
  npLastShow = millis();
  memcpy(npSent, npBuf, sizeof(npBuf));
  for (int i = 0; i < NEO_N; i++)
    ring.setPixelColor(i, ring.Color(npBuf[i][0], npBuf[i][1], npBuf[i][2]));
  ring.show();
  npLit = true;
}

static void npClear() {
  if (!npLit) return;
  if (!npRmtOk()) { npLit = false; return; }
  ring.clear();
  ring.show();
  memset(npSent, 0, sizeof(npSent));
  npLastShow = millis();
  npLit = false;
}

/* Colour for a pixel sitting at position `pos` (0..1) along a zoned scale.
 * Zones are chosen by where the PIXEL is, not by the current level, which is
 * what makes it read like a console meter rather than a colour-changing bar. */
static int32_t npZoneAt(float pos) {
  int zones = constrain((int)npMxZones, 2, 4);
  /* Nothing stops the thresholds being edited out of order, and if t3 fell
   * below t2 the zones would swap over. Order them here so a bad setting
   * degrades to a sensible meter instead of a scrambled one. */
  float t2 = npMxT2 / 100.0f;
  float t3 = max(t2, npMxT3 / 100.0f);
  float t4 = max(t3, npMxT4 / 100.0f);
  if (zones >= 4 && pos >= t4) return npMxZ4;
  if (zones >= 3 && pos >= t3) return npMxZ3;
  if (pos >= t2) return npMxZ2;
  return npMxZ1;
}

/* Draw a level as a scale.
 *
 * With smoothing on, the pixel straddling the level is lit proportionally to
 * how far into it the level reaches, so the ring reads as continuous rather
 * than as twelve discrete steps -- the same idea as anti-aliasing a line.  */
static void npScale(float frac, int32_t flatCol, bool zoned,
                    bool endsWarn, int32_t warnCol,
                    bool clipPix, bool clipFull) {
  frac = constrain(frac, 0.0f, 1.0f);
  float lit = frac * NEO_N;

  for (int i = 0; i < NEO_N; i++) {
    float level;
    if (lit >= (float)(i + 1))      level = 1.0f;
    else if (lit <= (float)i)       level = 0.0f;
    else                            level = npSmooth ? (lit - (float)i) : 1.0f;
    if (level <= 0.0f) continue;

    int32_t col = zoned ? npZoneAt(((float)i + 0.5f) / NEO_N) : flatCol;

    // Ends only turn warning-coloured at the actual extremes, so the ring
    // does not permanently look like it is complaining.
    if (endsWarn && i == 0 && frac <= 0.0005f)          col = warnCol;
    if (endsWarn && i == NEO_N - 1 && frac >= 0.9995f)  col = warnCol;

    bool isClip = clipPix && (i == NEO_N - 1);
    if (isClip) npSet(i, col, 1.0f, clipFull);   // never dimmed by level
    else        npSet(i, col, level, false);
  }

  /* At zero the loop above lights nothing, so the "at minimum" marker would
   * never appear. Light it explicitly -- that state is exactly the one worth
   * flagging. */
  if (endsWarn && frac <= 0.0005f) npSet(0, warnCol, 1.0f, false);

  // A clip pixel that is armed but not reached stays dark; once reached it is
  // full-on regardless of smoothing or master brightness.
  if (clipPix && frac > (float)(NEO_N - 1) / NEO_N) {
    int32_t col = zoned ? npZoneAt(1.0f) : flatCol;
    npSet(NEO_N - 1, col, 1.0f, clipFull);
  }
}

/* ---- HSV <-> RGB, for the colour editor -------------------------------- */
static void npToHSV(int32_t c, int *h, int *sv, int *v) {
  float r = npR(c) / 255.0f, g = npG(c) / 255.0f, b = npB(c) / 255.0f;
  float mx = max(r, max(g, b)), mn = min(r, min(g, b));
  float d = mx - mn;
  float hh = 0.0f;
  if (d > 0.0001f) {
    if (mx == r)      hh = 60.0f * fmodf((g - b) / d, 6.0f);
    else if (mx == g) hh = 60.0f * (((b - r) / d) + 2.0f);
    else              hh = 60.0f * (((r - g) / d) + 4.0f);
  }
  if (hh < 0) hh += 360.0f;
  *h  = (int)lroundf(hh) % 360;
  *sv = (int)lroundf((mx <= 0.0001f ? 0.0f : d / mx) * 100.0f);
  *v  = (int)lroundf(mx * 100.0f);
}

static int32_t npFromHSV(int h, int sv, int v) {
  float S = constrain(sv, 0, 100) / 100.0f;
  float V = constrain(v, 0, 100) / 100.0f;
  float H = (float)(((h % 360) + 360) % 360) / 60.0f;
  float C = V * S;
  float X = C * (1.0f - fabsf(fmodf(H, 2.0f) - 1.0f));
  float m = V - C;
  float r = 0, g = 0, b = 0;
  int i = (int)H;
  if (i == 0)      { r = C; g = X; }
  else if (i == 1) { r = X; g = C; }
  else if (i == 2) { g = C; b = X; }
  else if (i == 3) { g = X; b = C; }
  else if (i == 4) { r = X; b = C; }
  else             { r = C; b = X; }
  return npRGB((int)lroundf((r + m) * 255), (int)lroundf((g + m) * 255),
               (int)lroundf((b + m) * 255));
}

/* ###########################################################################
 * #                        ROTARY ENCODER                                   #
 * #                                                                         #
 * #  Interrupt-driven quadrature decode. Both edges of both channels feed a #
 * #  16-entry state table: the index is the previous AB pair concatenated   #
 * #  with the current one, and the table yields -1, 0 or +1. Illegal        #
 * #  transitions (contact bounce) map to 0, so bounce is rejected by the    #
 * #  decoder itself rather than by a debounce delay -- no rotation is ever  #
 * #  missed, however fast the knob is spun.                                 #
 * #                                                                         #
 * #  The encoder is RELATIVE. There is no absolute position, which is what  #
 * #  removes the entire class of sync bugs the servo + pot arrangement had: #
 * #  a remote change simply overwrites the value, and the next detent moves #
 * #  on from wherever it now sits. Nothing has to be reconciled.            #
 * ######################################################################### */

static const int8_t ENC_TABLE[16] = {
   0, -1, +1,  0,
  +1,  0,  0, -1,
  -1,  0,  0, +1,
   0, +1, -1,  0
};

static volatile int32_t  encRaw  = 0;    // quadrature transitions, signed
static volatile uint8_t  encPrev = 0;
static int32_t  encCarry = 0;            // sub-detent remainder
static uint32_t encLastMs = 0;
static int      encLastDir = 0;

static void IRAM_ATTR encISR() {
  uint8_t cur = (uint8_t)((digitalRead(PIN_ENC_A) << 1) | digitalRead(PIN_ENC_B));
  encRaw += ENC_TABLE[((encPrev << 2) | cur) & 0x0F];
  encPrev = cur;
}

static void encBegin() {
  // INPUT_PULLUP regardless of whether the breakout supplies its own.
  pinMode(PIN_ENC_A, INPUT_PULLUP);
  pinMode(PIN_ENC_B, INPUT_PULLUP);
  encPrev = (uint8_t)((digitalRead(PIN_ENC_A) << 1) | digitalRead(PIN_ENC_B));
  encRaw = 0;
  attachInterrupt(digitalPinToInterrupt(PIN_ENC_A), encISR, CHANGE);
  attachInterrupt(digitalPinToInterrupt(PIN_ENC_B), encISR, CHANGE);
}

// Discard anything accumulated but not yet consumed. Called on screen entry
// so a spin left over from the previous screen is not applied to this one.
static void knobInputMode();   // defined just below knobResetSteps

static void knobResetSteps() {
  noInterrupts();
  encRaw = 0;
  interrupts();
  encCarry = 0;
  encLastDir = 0;
}

static void knobUpdate() { /* nothing to poll: the ISR does the work */ }

// Screens call this on entry; with an encoder it just drops stale detents.
static void knobInputMode() { knobResetSteps(); }

/* Detents since the last call. Positive is clockwise unless inverted. */
static int knobSteps() {
  noInterrupts();
  int32_t r = encRaw;
  encRaw = 0;
  interrupts();
  if (!r) return 0;
  if (encCfgInvert) r = -r;
  if (sysKnobInvert) r = -r;

  encCarry += r;
  int div = constrain((int)encCfgDiv, 1, 8);
  int steps = (int)(encCarry / div);        // truncates toward zero
  encCarry -= (int32_t)steps * div;
  return steps;
}

/* Optional acceleration for continuous values (fader, volume, character
 * pick). Menus deliberately do not use it: skipping rows feels broken. */
static int knobAccelMul() {
  if (encCfgAccel <= 1) return 1;
  uint32_t now = millis();
  uint32_t gap = now - encLastMs;
  encLastMs = now;
  if (gap >= (uint32_t)encCfgAccelMs) return 1;
  // Scale linearly from 1x at the threshold up to the configured maximum.
  float f = 1.0f - (float)gap / (float)max((int)encCfgAccelMs, 1);
  int m = 1 + (int)lroundf(f * (float)(encCfgAccel - 1));
  return constrain(m, 1, (int)encCfgAccel);
}

static int knobStepsFast() {
  int s = knobSteps();
  if (!s) return 0;
  return s * knobAccelMul();
}

/* ###########################################################################
 * #                       NAVIGATION / APP STACK                            #
 * ######################################################################### */

static const int NAV_MAX = 6;
static const App *gStack[NAV_MAX];
static int gDepth = 0;
static const App *cur() { return gStack[gDepth]; }

static const App *ALL_APPS[40];   // grow with the app list below
static int ALL_APPS_N = 0;
static int appIndex(const App *a) {
  for (int i = 0; i < ALL_APPS_N; i++) if (ALL_APPS[i] == a) return i;
  return -1;
}

static bool gNavDirty = false;

static void navPush(const App *a) {
  if (!a || gDepth + 1 >= NAV_MAX) return;
  if (cur() && cur()->onExit) cur()->onExit();
  gStack[++gDepth] = a;
  if (a->onEnter) a->onEnter();
  gNavDirty = true;
}

static void navBack() {
  if (gDepth == 0) return;
  if (cur() && cur()->onExit) cur()->onExit();
  gDepth--;
  if (cur() && cur()->onEnter) cur()->onEnter();
  gNavDirty = true;
}

static void navReplace(const App *a) {
  if (!a || gDepth == 0) { navPush(a); return; }
  if (cur() && cur()->onExit) cur()->onExit();
  gStack[gDepth] = a;
  if (a->onEnter) a->onEnter();
  gNavDirty = true;
}

static void navHome() {
  while (gDepth > 0) {
    if (cur() && cur()->onExit) cur()->onExit();
    gDepth--;
  }
  if (cur() && cur()->onEnter) cur()->onEnter();
  gNavDirty = true;
}

// Apps with a `launch` hook can demand prerequisites before being entered.
static void launchApp(const App *a) {
  if (!a) return;
  if (a->launch) a->launch();
  else navPush(a);
}

static void navSaveNow() {
  int32_t *slots[4] = { &navSaved0, &navSaved1, &navSaved2, &navSaved3 };
  for (int i = 0; i < 4; i++)
    *slots[i] = (i <= gDepth && i < NAV_MAX) ? appIndex(gStack[i]) : -1;
  nvTouch();
}

/* ###########################################################################
 * #             BUTTONS: debounce, repeat, configurable back combo          #
 * ######################################################################### */

struct BtnState { bool down; uint32_t downMs, lastRepeat; bool pending, suppressed, stuck; };
static BtnState bs[B_COUNT];
static const int BTN_PINS[B_COUNT] = { PIN_BTN_C, PIN_BTN_B, PIN_BTN_A, PIN_ENC_SW };
static bool gComboFired = false;

static uint8_t backMask() {
  switch (sysBackAct) {
    case 1:  return (1 << B_B) | (1 << B_C);
    case 2:  return (1 << B_A) | (1 << B_C);
    case 3:  return (1 << B_A) | (1 << B_B) | (1 << B_C);
    default: return (1 << B_A) | (1 << B_B);
  }
}

static void doBack() {
  if (cur() && cur()->onBack && cur()->onBack()) return;
  navBack();
}

static void dispatch(BtnId b, BtnEv e) {
  batNoteActivity();
  if (cur() && cur()->onButton) cur()->onButton(b, e);
}

// Suppressed buttons are part of an in-flight back gesture, so a hold-to-seek
// must not see them.
static bool btnIsDown(BtnId b) { return bs[b].down && !bs[b].suppressed; }
static bool btnSuppressed(BtnId b) { return bs[b].suppressed; }

/* Generic UI screens treat the shaft click as another select. Apps that give
 * the shaft button its own meaning -- Speaker, Mixer, Text entry, Encoder
 * Test -- handle B_ENC themselves and never call this. */
static bool btnSelect(BtnId b) { return b == B_B || b == B_ENC; }
static uint32_t btnHeldFor(BtnId b) {
  return btnIsDown(b) ? (uint32_t)(millis() - bs[b].downMs) : 0;
}

/* After waking, the button that woke the device is still held down. Swallow
 * input until every button is released, otherwise the wake press also
 * activates whatever happens to sit under it. */
static bool wakeGuardBlocking() {
  if (!gWakeGuard) return false;
  for (int i = 0; i < B_COUNT; i++)
    if (digitalRead(BTN_PINS[i]) == LOW) { gLastActivity = millis(); return true; }
  gWakeGuard = false;
  for (int i = 0; i < B_COUNT; i++) {
    bs[i].down = false;
    bs[i].pending = false;
    bs[i].suppressed = false;
  }
  return false;
}

static void buttonsPoll() {
  for (int i = 0; i < B_COUNT; i++) {
    bool raw = (digitalRead(BTN_PINS[i]) == LOW);
    /* Something leaning on a button for many seconds is pressure, not a
     * deliberate hold. Once past the limit the button is ignored entirely
     * until it comes back up, so a bagged device cannot repeat its way
     * through a settings page. */
    if (raw && bs[i].down && sysStuckSec > 0 && !bs[i].stuck &&
        elapsed(bs[i].downMs, (uint32_t)sysStuckSec * 1000UL))
      bs[i].stuck = true;
    if (!raw) bs[i].stuck = false;
    if (raw && !bs[i].down) {
      bs[i] = { true, millis(), millis(), true, false };
    } else if (!raw && bs[i].down) {
      // Too short to be a finger: treat it as bounce and let the press that
      // follows stand on its own.
      if (bs[i].pending && !bs[i].suppressed && elapsed(bs[i].downMs, TAP_MIN_MS))
        dispatch((BtnId)i, EV_PRESS);
      bs[i].down = bs[i].pending = bs[i].suppressed = false;
    }
  }

  // Presses are deferred by COMBO_MS so a combo never fires its members first.
  uint8_t mask = backMask(), downMask = 0;
  for (int i = 0; i < B_COUNT; i++) if (bs[i].down) downMask |= (1 << i);

  if ((downMask & mask) == mask && !gComboFired) {
    for (int i = 0; i < B_COUNT; i++)
      if (mask & (1 << i)) { bs[i].pending = false; bs[i].suppressed = true; }
    gComboFired = true;
    doBack();
  }
  if ((downMask & mask) == 0) gComboFired = false;

  for (int i = 0; i < B_COUNT; i++) {
    // Only chord members need to wait; the rest fire at once so navigation
    // stays snappy while A+B still has time to form.
    uint32_t defer = (mask & (1 << i)) ? (uint32_t)sysComboMs : COMBO_MS;
    if (bs[i].stuck) bs[i].pending = false;
    if (bs[i].pending && elapsed(bs[i].downMs, defer)) {
      bs[i].pending = false;
      if (!bs[i].suppressed) dispatch((BtnId)i, EV_PRESS);
    }
    if (bs[i].down && !bs[i].pending && !bs[i].suppressed &&
        sysRepeatDly > 0 && !bs[i].stuck &&
        elapsed(bs[i].downMs, (uint32_t)sysRepeatDly) &&
        elapsed(bs[i].lastRepeat, (uint32_t)sysRepeatRate)) {
      bs[i].lastRepeat = millis();
      dispatch((BtnId)i, EV_REPEAT);
    }
  }
}

/* ###########################################################################
 * #                    CONFIG PAGE ENGINE                                   #
 * #                                                                         #
 * #  One generic driver renders every menu AND every settings page: a menu  #
 * #  is just a page whose rows are all C_LINK. To add a screen, declare a   #
 * #  CfgItem[] plus a CfgPage, then wrap it in a three-line App.            #
 * ######################################################################### */

static CfgPage *gCfg = nullptr;
static const CfgItem *gDropItem = nullptr;

static void applySystemCfg() {
  display.setRotation(sysFlip ? 3 : 1);
  display.setContrast((uint8_t)constrain(sysBright, 1, 255));
}

static void cfgValueText(const CfgItem *it, char *buf, size_t n) {
  buf[0] = 0;
  if (it->fmt) { it->fmt(buf, n); return; }
  switch (it->type) {
    case C_INT:
      snprintf(buf, n, "%ld%s", (long)*it->val, it->unit ? it->unit : "");
      break;
    case C_BOOL:
      snprintf(buf, n, "%s", *it->val ? "On" : "Off");
      break;
    case C_CHECK: break;              // the tick box in the tail says it
    case C_ENUM: {
      int32_t v = constrain(*it->val, 0, (int32_t)it->nopts - 1);
      snprintf(buf, n, "%s", it->opts[v]);
      break;
    }
    default: break;
  }
}

static bool cfgEditable(const CfgItem *it) {
  return it->type == C_INT || it->type == C_BOOL || it->type == C_ENUM;
}

/* ---- conditional rows ---------------------------------------------------
 * A row whose `visible` hook returns false is skipped entirely, so a setting
 * that only means something in one mode does not sit there greyed out or,
 * worse, quietly doing nothing. `sel` therefore counts VISIBLE rows, and
 * every access goes through cfgItemAt(). The mapping is recomputed per use
 * rather than cached: pages are at most a couple of dozen rows and the hooks
 * are single comparisons, so there is nothing to gain by holding state that
 * could go stale the moment the mode it depends on changes. */
static bool cfgShown(const CfgItem *it) { return !it->visible || it->visible(); }

static int cfgVisN(const CfgPage *p) {
  int n = 0;
  for (int i = 0; i < p->n; i++) if (cfgShown(&p->items[i])) n++;
  return n;
}

static const CfgItem *cfgItemAt(const CfgPage *p, int k) {
  if (k < 0) return nullptr;
  for (int i = 0; i < p->n; i++)
    if (cfgShown(&p->items[i]) && k-- == 0) return &p->items[i];
  return nullptr;
}

static const char *cfgLabel(const CfgItem *it) {
  return it->dynLabel ? it->dynLabel() : it->label;
}

// Long enum labels crowd the row, so those open a full-screen picker instead.
static bool cfgNeedsDropdown(const CfgItem *it) {
  if (it->type != C_ENUM || !it->opts) return false;
  int w = 0;
  for (int i = 0; i < it->nopts; i++) w = max(w, textW(it->opts[i]));
  return (textW(cfgLabel(it)) + w + 14) > ROW_W;
}

static void cfgAdjust(const CfgItem *it, int steps) {
  if (!cfgEditable(it) || !steps) return;
  int32_t v = *it->val;
  if (it->type == C_BOOL) {
    v = (v + steps) & 1;
  } else if (it->type == C_ENUM) {
    int n = it->nopts;
    v = ((v + steps) % n + n) % n;
  } else {
    v = constrain(v + (int32_t)steps * it->step, it->lo, it->hi);
  }
  if (v != *it->val) {
    *it->val = v;
    nvTouch();
    if (it->val == &sysBright || it->val == &sysFlip) applySystemCfg();
  }
}

static void cfgOpen(CfgPage *p) {
  gCfg = p;
  p->editing = false;
  knobInputMode();
}

static void cfgDraw() {
  if (!gCfg) return;
  CfgPage *p = gCfg;
  drawTitle(p->dynTitle ? p->dynTitle() : p->title);

  int n = cfgVisN(p);
  if (p->sel >= n) p->sel = (uint8_t)max(0, n - 1);

  int first = 0;
  if (p->sel >= ROWS_VIS) first = p->sel - ROWS_VIS + 1;
  if (first > n - ROWS_VIS) first = max(0, n - ROWS_VIS);

  for (int i = 0; i < ROWS_VIS && first + i < n; i++) {
    int idx = first + i, y = ROW_TOP + i * ROW_H;
    const CfgItem *it = cfgItemAt(p, idx);
    if (!it) break;
    bool sel = (idx == p->sel);
    char vb[24];
    cfgValueText(it, vb, sizeof(vb));
    Glyph tail = (it->type == C_LINK)  ? G_RIGHT
               : (it->type == C_CHECK) ? (*it->val ? G_CHECK_ON : G_CHECK_OFF)
                                       : G_NONE;
    drawRow(y, sel, sel && p->editing, cfgLabel(it), vb[0] ? vb : nullptr, tail);
  }
  drawScrollbar(n, first);
  drawButtonLabels(G_UP, p->editing ? G_SELECT_OPEN : G_SELECT, G_DOWN);
}

static void cfgMove(int d) {
  if (!gCfg || !gCfg->n) return;
  int n = cfgVisN(gCfg);
  if (!n) return;
  int s = (int)gCfg->sel + d;
  gCfg->sel = (uint8_t)constrain(s, 0, n - 1);
}

static void cfgActivate();   // defined after the dropdown app

static void cfgButton(BtnId b, BtnEv e) {
  if (!gCfg || !gCfg->n) return;
  const CfgItem *it = cfgItemAt(gCfg, gCfg->sel);
  if (!it) return;
  if (gCfg->editing) {
    if (b == B_C) cfgAdjust(it, +1);
    else if (b == B_A) cfgAdjust(it, -1);
    else if (btnSelect(b) && e == EV_PRESS) gCfg->editing = false;
    return;
  }
  if (b == B_C) cfgMove(-1);
  else if (b == B_A) cfgMove(+1);
  else if (btnSelect(b) && e == EV_PRESS) cfgActivate();
}

static void cfgKnob(int steps) {
  if (!gCfg || !gCfg->n || !steps) return;
  const CfgItem *it = cfgItemAt(gCfg, gCfg->sel);
  if (!it) return;
  bool edits = gCfg->editing || (sysKnobEdit == 0 && cfgEditable(it));
  if (edits) cfgAdjust(it, steps);
  else cfgMove(steps > 0 ? +1 : -1);
}

/* ---- dropdown picker for enums whose labels won't fit inline ------------- */
static uint8_t gDropSel = 0;

static void dropEnter() { knobInputMode(); gDropSel = gDropItem ? (uint8_t)constrain(*gDropItem->val, 0, (int32_t)gDropItem->nopts - 1) : 0; }

static void dropDraw() {
  if (!gDropItem) return;
  drawTitle(cfgLabel(gDropItem));
  int n = gDropItem->nopts;
  int first = (gDropSel >= ROWS_VIS) ? gDropSel - ROWS_VIS + 1 : 0;
  for (int i = 0; i < ROWS_VIS && first + i < n; i++) {
    int idx = first + i;
    drawRow(ROW_TOP + i * ROW_H, idx == gDropSel, false,
            gDropItem->opts[idx], nullptr, G_NONE);
  }
  drawScrollbar(n, first);
  drawButtonLabels(G_UP, G_SELECT, G_DOWN);
}

static void dropMove(int d) {
  if (!gDropItem) return;
  gDropSel = (uint8_t)constrain((int)gDropSel + d, 0, (int)gDropItem->nopts - 1);
}

static void dropButton(BtnId b, BtnEv e) {
  if (b == B_C) dropMove(-1);
  else if (b == B_A) dropMove(+1);
  else if (btnSelect(b) && e == EV_PRESS && gDropItem) {
    *gDropItem->val = gDropSel;
    nvTouch();
    applySystemCfg();
    navBack();
  }
}

static void dropKnob(int s) { if (s) dropMove(s > 0 ? +1 : -1); }

static const App AppDropdown = {
  "Select", nullptr, dropEnter, nullptr, nullptr, dropDraw, dropButton, dropKnob,
  nullptr, nullptr
};

static void cfgActivate() {
  const CfgItem *it = cfgItemAt(gCfg, gCfg->sel);
  if (!it) return;
  switch (it->type) {
    case C_LINK: if (it->target) launchApp(it->target); break;
    case C_ACT:  if (it->action) it->action(); break;
    /* A checkbox toggles on the spot. Dropping into an edit mode to change a
     * two-state value you can already see is a step that buys nothing. */
    case C_CHECK: if (it->val) { *it->val = !*it->val; nvTouch(); } break;
    case C_ENUM:
      if (cfgNeedsDropdown(it)) { gDropItem = it; navPush(&AppDropdown); }
      else gCfg->editing = true;
      break;
    case C_INT:
    case C_BOOL: gCfg->editing = true; break;
    default: break;
  }
}

// Re-entering a config page (e.g. on back) must restore it as the active page.
#define CFG_APP(fnprefix, pagevar)                                            \
  static void fnprefix##Enter() { cfgOpen(&pagevar); }                        \
  static void fnprefix##Exit()  { if (gCfg == &pagevar) pagevar.editing = false; }

/* ###########################################################################
 * #                          TEXT INPUT                                     #
 * #  Knob picks the character, A/C move the cursor, B confirms. A blank     #
 * #  cell that the cursor leaves is deleted. There is always one trailing   #
 * #  blank so the string can grow.                                          #
 * ######################################################################### */

static const char TI_CHARS[] =
  "abcdefghijklmnopqrstuvwxyz"
  "ABCDEFGHIJKLMNOPQRSTUVWXYZ"
  "0123456789"
  "-_.:/@#$%&*+=!?,;'\"()[]{}<>|\\^~` ";

static TextReq gTi;
static uint8_t tiIdx[80];
static int tiCells = 1, tiCur = 0;
static bool  tiEditing = false;

static int tiN() { return (int)strlen(TI_CHARS); }
static char tiChar(int i) { return (i <= 0) ? 0 : TI_CHARS[i - 1]; }
/* Past the last character cell sit two buttons, reached by continuing to
 * press right: OK then Clear. Same idea as the IP editor. */
static bool tiOnOk()    { return tiCur == tiCells; }
static bool tiOnClear() { return tiCur == tiCells + 1; }
static bool tiPastEnd() { return tiCur >= tiCells; }

/* With a relative encoder there is nothing to re-arm: moving the cursor no
 * longer risks the knob's resting position overwriting the new cell. Kept as
 * a no-op so every call site does not have to change. */
static void tiArmKnob() { knobResetSteps(); }

// Shaft button toggles the case of the letters being entered.
/* Caps lock is a MODE, not a one-shot remap.
 *
 * TI_CHARS holds both cases back to back, so the old toggle merely jumped to
 * the matching letter in the other half: it changed one character, and the
 * very next detent stepped straight back into the other case. Instead the
 * rotation order is filtered, offering only letters of the active case, so
 * the lock genuinely holds for everything typed afterwards.
 *
 * raw index: 0 = blank, otherwise TI_CHARS offset + 1
 *   TI_CHARS[0..25] lower, [26..51] upper, [52..] digits and symbols      */
static bool tiCaps = false;

static const int TI_LETTERS = 26;
static int tiEffCount() { return 1 + TI_LETTERS + (tiN() - 2 * TI_LETTERS); }

// effective position -> raw index, wrapping at both ends
static int tiEffToRaw(int pos) {
  int n = tiEffCount();
  pos = ((pos % n) + n) % n;
  if (pos == 0) return 0;                                    // blank
  if (pos <= TI_LETTERS) return (tiCaps ? TI_LETTERS : 0) + pos;
  return 2 * TI_LETTERS + (pos - TI_LETTERS);                // digits, symbols
}

// raw index -> effective position; letters fold onto the active case
static int tiRawToEff(int raw) {
  if (raw <= 0) return 0;
  int c = raw - 1;
  if (c < TI_LETTERS) return c + 1;                          // lower
  if (c < 2 * TI_LETTERS) return c - TI_LETTERS + 1;         // upper
  return c - 2 * TI_LETTERS + TI_LETTERS + 1;
}

static void textInputBegin(const char *title, char *buf, uint8_t cap,
                           void (*onDone)()) {
  gTi.title = title; gTi.buf = buf; gTi.cap = cap; gTi.onDone = onDone;
  memset(tiIdx, 0, sizeof(tiIdx));
  tiCells = 1; tiCur = 0; tiEditing = false;
  for (int i = 0; buf[i] && i < cap - 1 && i < (int)sizeof(tiIdx) - 2; i++) {
    const char *p = strchr(TI_CHARS, buf[i]);
    tiIdx[i] = p ? (uint8_t)(p - TI_CHARS + 1) : 0;
    tiCells = i + 2;
  }
  tiIdx[tiCells - 1] = 0;
  tiCur = tiCells - 1;
}

static void tiClearAll() {
  memset(tiIdx, 0, sizeof(tiIdx));
  tiCells = 1;
  tiCur = 0;
  tiEditing = false;
  tiArmKnob();
}

static void tiEnter() { knobInputMode(); tiArmKnob(); }

static void tiGrowIfNeeded() {
  if (tiCur == tiCells - 1 && tiIdx[tiCur] != 0 &&
      tiCells < (int)((gTi.cap < sizeof(tiIdx) ? gTi.cap : sizeof(tiIdx)) - 1)) {
    tiCells++;
    tiIdx[tiCells - 1] = 0;
  }
}

static void tiRotate(int steps) {
  tiIdx[tiCur] = (uint8_t)tiEffToRaw(tiRawToEff(tiIdx[tiCur]) + steps);
  tiGrowIfNeeded();
}

/* Detents step through the character set, wrapping at both ends. Acceleration
 * applies here: a slow turn picks neighbours precisely, a fast spin crosses
 * the alphabet without a long grind. */
static void tiApplyKnob() {
  if (tiPastEnd()) return;
  int s = knobStepsFast();
  if (s) tiRotate(s);
}

/* Flip the mode, then re-map the character under the cursor through the new
 * mapping so the screen matches what further rotation will now produce.
 * Non-letters are unaffected: their effective position is case-independent. */
static void tiToggleCaps() {
  tiCaps = !tiCaps;
  if (tiPastEnd()) return;
  int raw = tiIdx[tiCur];
  if (raw <= 0 || raw - 1 >= 2 * TI_LETTERS) return;
  tiIdx[tiCur] = (uint8_t)tiEffToRaw(tiRawToEff(raw));
}

static void tiDeleteAt(int c) {
  for (int i = c; i < tiCells - 1; i++) tiIdx[i] = tiIdx[i + 1];
  if (tiCells > 1) tiCells--;
}

static void tiMove(int d) {
  if (tiPastEnd()) {
    if (d > 0) { if (tiOnOk()) tiCur = tiCells + 1; }     // OK -> Clear
    else       { tiCur = tiOnClear() ? tiCells : tiCells - 1; }
    tiArmKnob();
    return;
  }
  bool blank = (tiIdx[tiCur] == 0) && (tiCur < tiCells - 1);
  if (d > 0) {
    if (blank) tiDeleteAt(tiCur);              // leaving a blank deletes it
    else if (tiCur < tiCells - 1) tiCur++;
    else tiCur = tiCells;                      // past the last cell is OK
  } else {
    if (blank) { tiDeleteAt(tiCur); if (tiCur > 0) tiCur--; }
    else if (tiCur > 0) tiCur--;
  }
  tiArmKnob();
}

static void tiCommit() {
  int o = 0;
  for (int i = 0; i < tiCells && o < gTi.cap - 1; i++) {
    char c = tiChar(tiIdx[i]);
    if (c) gTi.buf[o++] = c;
  }
  gTi.buf[o] = 0;
}

static void tiDraw() {
  drawTitle(gTi.title);

  const int cw = 7, y = 20, vis = CONTENT_W / cw;
  int anchor = min(tiCur, tiCells - 1);
  int first = (anchor >= vis) ? anchor - vis + 1 : 0;

  for (int i = 0; i < vis && first + i < tiCells; i++) {
    int idx = first + i, x = i * cw;
    bool cursor = (idx == tiCur);
    if (cursor) display.fillRect(x, y - 1, cw, 11, SH110X_WHITE);
    char c = tiChar(tiIdx[idx]);
    uint16_t fg = cursor ? SH110X_BLACK : SH110X_WHITE;
    display.setTextColor(fg);
    if (c == ' ') display.drawFastHLine(x + 1, y + 7, 5, fg);
    else if (c)  { display.setCursor(x + 1, y + 1); display.print(c); }
    display.setTextColor(SH110X_WHITE);
    if (!cursor) display.drawFastHLine(x, y + 10, cw - 1, SH110X_WHITE);
    // clicked into this cell: chevrons show A/C now cycle the character
    if (cursor && tiEditing) {
      drawGlyph(x + cw / 2, y - 5, G_UP, SH110X_WHITE);
      drawGlyph(x + cw / 2, y + 15, G_DOWN, SH110X_WHITE);
    }
  }

  int used = 0;
  for (int i = 0; i < tiCells; i++) if (tiIdx[i]) used++;
  display.setCursor(0, 40);
  if (tiPastEnd()) display.printf("%d/%d chars", used, gTi.cap - 1);
  else {
    char c = tiChar(tiIdx[tiCur]);
    if (!c)           display.printf("%d/%d  [blank]", used, gTi.cap - 1);
    else if (c == ' ')display.printf("%d/%d  [space]", used, gTi.cap - 1);
    else              display.printf("%d/%d  '%c'", used, gTi.cap - 1, c);
  }

  // OK and Clear, bottom right of the content area
  const int btnH = 14, btnY = 48;
  const int okW = 26, clW = 38;
  const int okX = CONTENT_W - okW - 1;
  const int clX = okX - clW - 4;
  struct { int x, w; const char *l; bool sel; } tb[2] = {
    { clX, clW, "Clear", tiOnClear() },
    { okX, okW, "OK",    tiOnOk()    },
  };
  for (int i = 0; i < 2; i++) {
    if (tb[i].sel) {
      display.fillRoundRect(tb[i].x, btnY, tb[i].w, btnH, 4, SH110X_WHITE);
      display.setTextColor(SH110X_BLACK);
    } else {
      display.drawRoundRect(tb[i].x, btnY, tb[i].w, btnH, 4, SH110X_WHITE);
      display.setTextColor(SH110X_WHITE);
    }
    display.setCursor(tb[i].x + (tb[i].w - (int)strlen(tb[i].l) * 6) / 2, btnY + 4);
    display.print(tb[i].l);
    display.setTextColor(SH110X_WHITE);
  }

  if (encCfgTextBtn == 0 && !tiPastEnd()) {   // shaft click toggles case
    display.setCursor(0, 52);
    display.print(tiCaps ? "ABC" : "abc");
  }

  if (tiEditing)        drawButtonLabels(G_UP, G_SELECT_OPEN, G_DOWN);
  else if (tiOnClear()) drawButtonLabels(G_NONE, G_SELECT, G_LEFT);
  else                  drawButtonLabels(G_RIGHT, G_SELECT, G_LEFT);
}

static void tiButton(BtnId b, BtnEv e) {
  if (tiEditing) {                       // A/C cycle the character
    if (b == B_C) tiRotate(+1);
    else if (b == B_A) tiRotate(-1);
    else if (b == B_B && e == EV_PRESS) tiEditing = false;
    return;
  }
  if (b == B_C) tiMove(+1);
  else if (b == B_A) tiMove(-1);
  else if (b == B_B && e == EV_PRESS) {
    if (tiOnClear()) tiClearAll();
    else if (tiOnOk()) { tiCommit(); if (gTi.onDone) gTi.onDone(); }
    else tiEditing = true;
  } else if (b == B_ENC && e == EV_PRESS) {
    // Shaft click follows the selection when it is on a button, so the
    // encoder can drive the whole screen without reaching for B.
    if (tiOnClear()) tiClearAll();
    else if (tiOnOk()) { tiCommit(); if (gTi.onDone) gTi.onDone(); }
    else if (encCfgTextBtn == 0) tiToggleCaps();
    else if (encCfgTextBtn == 1) { tiCommit(); if (gTi.onDone) gTi.onDone(); }
  }
}

static void tiTick() { tiApplyKnob(); }

static const App AppTextInput = {
  "Text Input", nullptr, tiEnter, nullptr, tiTick, tiDraw, tiButton, nullptr,
  nullptr, nullptr
};

/* ###########################################################################
 * #                            IP INPUT                                     #
 * #  Twelve digit cells shown as ___.___.___.___ ; the cursor skips dots.   #
 * #  Knob cycles blank,0..9. Invalid entries are rejected and clear the IP. #
 * ######################################################################### */

static int8_t ipD[12];
static int ipCur = 0;
static int32_t *gIpTarget = nullptr;
static const char *gIpTitle = "IP Address";
static void (*gIpDone)() = nullptr;
static bool gIpError = false;

static void ipInputBegin(int32_t *target, const char *title, void (*onDone)()) {
  gIpTarget = target; gIpTitle = title; ipField = 0;
  gIpApply = nullptr;
  uint32_t packed = target ? (uint32_t)*target : 0;
  gIpDone = onDone; gIpError = false; ipCur = 0;
  for (int i = 0; i < 12; i++) ipD[i] = -1;
  if (packed) {
    for (int o = 0; o < 4; o++) {
      int v = (packed >> (8 * o)) & 0xFF;     // IPAddress packs LSB = first octet
      ipD[o * 3 + 0] = (v / 100) % 10;
      ipD[o * 3 + 1] = (v / 10) % 10;
      ipD[o * 3 + 2] = v % 10;
    }
  }
}

static void ipArmKnob() { knobResetSteps(); }
static void ipEnter() { knobInputMode(); ipArmKnob(); }

// Detents cycle blank, 0..9 and wrap. No acceleration: eleven values is a
// short list and precision matters more than speed.
static void ipApplyKnob() {
  if (gIpError || ipField != 0) return;   // knob edits digits only
  int st = knobSteps();
  if (!st) return;
  int v = (int)ipD[ipCur] + 1 + st;       // 0 = blank, 1..10 = 0..9
  v %= 11;
  if (v < 0) v += 11;
  ipD[ipCur] = (int8_t)(v - 1);
}
static void ipTick() { ipApplyKnob(); }

static bool ipParse(uint32_t *out) {
  uint32_t packed = 0;
  for (int o = 0; o < 4; o++) {
    int firstD = -1, lastD = -1;
    for (int k = 0; k < 3; k++) {
      if (ipD[o * 3 + k] >= 0) { if (firstD < 0) firstD = k; lastD = k; }
    }
    if (firstD < 0) return false;                       // empty octet
    for (int k = firstD; k <= lastD; k++)
      if (ipD[o * 3 + k] < 0) return false;             // gap inside the octet
    int v = 0;
    for (int k = firstD; k <= lastD; k++) v = v * 10 + ipD[o * 3 + k];
    if (v > 255) return false;
    packed |= ((uint32_t)v) << (8 * o);
  }
  *out = packed;
  return true;
}

static void ipDraw() {
  if (gIpError) {
    uiWide();
    drawTitle("Invalid IP");
    display.setCursor(0, 20);
    display.print("Octets must be");
    display.setCursor(0, 30);
    display.print("0-255 with no");
    display.setCursor(0, 40);
    display.print("gaps. IP cleared.");
    display.setCursor(0, 54);
    display.print("back to exit");
    return;
  }

  drawTitle(gIpTitle);
  const int cw = 7, y = 24;
  for (int c = 0; c < 15; c++) {
    int x = c * cw;
    if (c % 4 == 3) { display.setCursor(x + 2, y + 1); display.print('.'); continue; }
    int d = c - c / 4;
    bool cursor = (d == ipCur) && ipField == 0;
    if (cursor) display.fillRect(x, y - 1, cw, 11, SH110X_WHITE);
    display.setTextColor(cursor ? SH110X_BLACK : SH110X_WHITE);
    if (ipD[d] >= 0) { display.setCursor(x + 1, y + 1); display.print((char)('0' + ipD[d])); }
    display.setTextColor(SH110X_WHITE);
    if (!cursor) display.drawFastHLine(x, y + 10, cw - 1, SH110X_WHITE);
  }
  /* Demo and Clear sit past the last digit: keep pressing right to reach
   * them. Only the mixer offers Demo. */
  const int by = 40, bh = 13;
  const char *lbl[2]; int bw[2]; int nb = 0;
  if (gIpAllowDemo) { lbl[nb] = "Demo"; bw[nb] = 34; nb++; }
  lbl[nb] = "Clear"; bw[nb] = 40; nb++;

  int bx = 0;
  for (int i = 0; i < nb; i++) {
    int field = gIpAllowDemo ? i + 1 : 2;
    bool sel = (ipField == field);
    if (sel) {
      display.fillRoundRect(bx, by, bw[i], bh, 3, SH110X_WHITE);
      display.setTextColor(SH110X_BLACK);
    } else {
      display.drawRoundRect(bx, by, bw[i], bh, 3, SH110X_WHITE);
      display.setTextColor(SH110X_WHITE);
    }
    display.setCursor(bx + (bw[i] - (int)strlen(lbl[i]) * 6) / 2, by + 4);
    display.print(lbl[i]);
    display.setTextColor(SH110X_WHITE);
    bx += bw[i] + 4;
  }

  display.setCursor(0, 56);
  if (ipField == 0)      display.print("click confirms");
  else if (ipField == 1) display.print("run without mixer");
  else                   display.print("erase the IP");

  drawButtonLabels(G_RIGHT, G_SELECT, G_LEFT);
}

static void ipCommit() {
  uint32_t packed;
  if (ipParse(&packed)) {
    if (gIpTarget) *gIpTarget = (int32_t)packed;
    nvTouch(); nvFlush();
    if (gIpApply) gIpApply();
    if (gIpDone) gIpDone(); else navBack();
  } else {
    if (gIpTarget) *gIpTarget = 0;
    nvTouch(); nvFlush();
    gIpError = true;
  }
}

static void ipClear() {
  for (int i = 0; i < 12; i++) ipD[i] = -1;
  if (gIpTarget) *gIpTarget = 0;
  nvTouch(); nvFlush();
  if (gIpApply) gIpApply();
  ipCur = 0; ipField = 0;
  ipArmKnob();
}

static void ipButton(BtnId b, BtnEv e) {
  if (gIpError) return;
  // Buttons live past the last digit: keep moving right to reach them.
  if (b == B_C) {
    if (ipField == 0 && ipCur < 11) ipCur++;
    else if (ipField == 0) ipField = gIpAllowDemo ? 1 : 2;
    else if (ipField < 2) ipField++;
    ipArmKnob();
  } else if (b == B_A) {
    if (ipField > 0) {
      if (gIpAllowDemo && ipField == 2) ipField = 1;
      else { ipField = 0; ipCur = 11; }
    } else if (ipCur > 0) ipCur--;
    ipArmKnob();
  } else if (btnSelect(b) && e == EV_PRESS) {
    if (ipField == 0) ipCommit();
    else if (ipField == 1) { if (gIpDemo) gIpDemo(); }
    else ipClear();
  }
}


static const App AppIpInput = {
  "IP Address", nullptr, ipEnter, nullptr, ipTick, ipDraw, ipButton, nullptr,
  nullptr, nullptr
};

/* ###########################################################################
 * #                           WI-FI APPS                                    #
 * ######################################################################### */

static const App *gAfterConnect = nullptr;   // resume target once prereqs are met
static bool gWifiGateway = false;            // Wi-Fi page entered as a gate
static bool gWifiOfferDemo = false;          // ...and the mixer is what wants it
static bool gSpkGateway  = false;            // Speaker page entered as a gate

static bool wifiConfigured() { return wifiSsid[0] != 0; }
static bool wifiOnline()     { return WiFi.status() == WL_CONNECTED; }

static const char *wifiTitle() {
  if (wifiOnline())      return "Wi-Fi: Connected";
  if (!wifiConfigured()) return "Wi-Fi: Setup";
  return "Wi-Fi: Offline";
}

/* ---- connecting / loading screen ---------------------------------------- */
static uint32_t wcStart = 0;
static bool wcFailed = false;

static void wcEnter() {
  wcStart = millis();
  wcFailed = false;
  WiFi.disconnect(false, true);
  delay(50);
  WiFi.mode(WIFI_STA);
  WiFi.setSleep(false);
  WiFi.begin(wifiSsid, wifiPass);
  wifiTune();
}

static void wcTick() {
  if (wcFailed) return;
  if (wifiOnline()) {
    nvNetRemember(wifiSsid, wifiPass);
    nvFlush();
    if (gAfterConnect) {
      const App *t = gAfterConnect;
      gAfterConnect = nullptr;
      gWifiGateway = false;
      gWifiOfferDemo = false;   // the reason for offering it is gone
      navHome();
      launchApp(t);
    } else navBack();
    return;
  }
  if (elapsed(wcStart, WIFI_TIMEOUT_MS)) wcFailed = true;
}

static void wcDraw() {
  uiWide();
  drawTitle(wcFailed ? "Connection Failed" : "Connecting...");
  display.setCursor(0, 20);
  printClipped(0, 20, wifiSsid, CONTENT_W);
  if (wcFailed) {
    display.setCursor(0, 34);
    display.print("Check password");
    display.setCursor(0, 44);
    display.print("or signal.");
    display.setCursor(0, 56);
    display.print("back to exit");
  } else {
    display.setCursor(0, 36);
    display.printf("%lus / %lus", (unsigned long)((millis() - wcStart) / 1000),
                   (unsigned long)(WIFI_TIMEOUT_MS / 1000));
    drawBar(0, 48, CONTENT_W, 7, (float)(millis() - wcStart) / WIFI_TIMEOUT_MS);
  }
}

static const App AppWifiConnect = {
  "Connecting", nullptr, wcEnter, nullptr, wcTick, wcDraw, nullptr, nullptr,
  nullptr, nullptr
};

/* ---- password step shared by both entry paths --------------------------- */
static void wifiGoConnect() { navReplace(&AppWifiConnect); }

static void wifiAskPassword() {
  textInputBegin("Wi-Fi Password", wifiPass, sizeof(wifiPass), wifiGoConnect);
  navReplace(&AppTextInput);
}

static void wifiAfterSsid() {
  if (!wifiSsid[0]) { navBack(); return; }
  wifiAskPassword();
}

static void wifiManualStart() {
  textInputBegin("Wi-Fi SSID", wifiSsid, sizeof(wifiSsid), wifiAfterSsid);
  navPush(&AppTextInput);
}

/* ---- scan --------------------------------------------------------------- */
static int wsCount = -1;      // -1 scanning, >=0 results
static int wsSel = 0;

static uint32_t wsStart = 0;
static int      wsRetries = 0;
static bool     wsFailed = false;

static bool wsWaiting = false;      // waiting out the gap before a retry

static void wsBeginScan() {
  if (WiFi.getMode() != WIFI_STA && WiFi.getMode() != WIFI_AP_STA)
    WiFi.mode(WIFI_STA);            // only if needed: mode() resets the radio
  WiFi.scanDelete();
  // show_hidden = true: APs that suppress their SSID still appear, which is
  // otherwise indistinguishable from "no networks here".
  int r = WiFi.scanNetworks(true, true);
  wsStart = millis();
  // A synchronous rejection means the radio is busy right now; wait rather
  // than burning a retry immediately.
  wsWaiting = (r == WIFI_SCAN_FAILED);
}

static void wsEnter() {
  knobInputMode();
  wsCount = -1;
  wsSel = 0;
  wsRetries = 0;
  wsFailed = false;
  wsWaiting = false;
  wsBeginScan();
}

static void wsExit() { WiFi.scanDelete(); }

/* scanComplete() returns -1 while running and -2 on failure. The old code
 * accepted only n >= 0, so a failed scan left the screen saying "Scanning"
 * forever -- and a scan started while the radio is busy associating or
 * reconnecting fails routinely, which is exactly why this behaved
 * differently in different places. Failures and stalls now retry, then give
 * up visibly instead of silently. */
/* scanComplete() returns -1 while running and -2 on failure -- and also -2
 * when no scan is running at all, which is what a rejected start looks like.
 * The previous version retried the instant it saw -2, so three retries were
 * spent inside a few hundred milliseconds and it reported failure before the
 * radio had any chance to become free. Retries are now spaced out. */
static void wsTick() {
  if (wsCount >= 0 || wsFailed) return;

  if (wsWaiting) {                      // hold off, then start again
    if (!elapsed(wsStart, 1200)) return;
    wsWaiting = false;
    wsRetries++;
    if (wsRetries > 6) { wsFailed = true; return; }
    wsBeginScan();
    return;
  }

  int n = WiFi.scanComplete();
  if (n >= 0) { wsCount = n; return; }

  bool bad = (n == WIFI_SCAN_FAILED) || elapsed(wsStart, 10000);
  if (!bad) return;
  if (wsRetries > 6) { wsFailed = true; return; }
  wsWaiting = true;                     // wsTick above will restart it
  wsStart = millis();
}

static void drawSignalBars(int x, int y, int rssi) {
  int lvl = (rssi > -55) ? 4 : (rssi > -65) ? 3 : (rssi > -75) ? 2 : 1;
  for (int i = 0; i < 4; i++) {
    int h = 2 + i * 2;
    if (i < lvl) display.fillRect(x + i * 4, y + 9 - h, 3, h, SH110X_WHITE);
    else         display.drawFastHLine(x + i * 4, y + 8, 3, SH110X_WHITE);
  }
}

static void drawLock(int x, int y) {
  display.fillRect(x, y + 4, 5, 4, SH110X_WHITE);
  display.drawFastHLine(x + 1, y + 2, 3, SH110X_WHITE);
  display.drawPixel(x, y + 3, SH110X_WHITE);
  display.drawPixel(x + 4, y + 3, SH110X_WHITE);
}

static void wsDraw() {
  if (wsCount <= 0) uiWide();
  drawTitle("Scan");
  if (wsFailed) {
    display.setCursor(0, 22);
    display.print("Scan failed");
    display.setCursor(0, 36);
    display.print("Radio busy. Try");
    display.setCursor(0, 46);
    display.print("again, or Manual.");
    drawButtonLabels(G_NONE, G_SELECT, G_NONE);
    return;
  }
  if (wsCount < 0) {
    display.setCursor(0, 28);
    display.printf("Scanning...%s", wsRetries ? " (retry)" : "");
    if (wsRetries) { display.setCursor(0, 38); display.printf("attempt %d/7", wsRetries + 1); }
    drawBar(0, 44, CONTENT_W, 6,
            (float)(millis() - wsStart) / 12000.0f);
    return;
  }
  if (wsCount == 0) {
    display.setCursor(0, 28);
    display.print("No networks found");
    display.setCursor(0, 44);
    display.print("back to exit");
    return;
  }

  int first = (wsSel >= ROWS_VIS) ? wsSel - ROWS_VIS + 1 : 0;
  for (int i = 0; i < ROWS_VIS && first + i < wsCount; i++) {
    int idx = first + i, y = ROW_TOP + i * ROW_H;
    bool sel = (idx == wsSel);
    if (sel) display.fillRect(0, y, ROW_W, ROW_H - 1, SH110X_WHITE);
    display.setTextColor(sel ? SH110X_BLACK : SH110X_WHITE);
    printClipped(3, y + 2, WiFi.SSID(idx).c_str(), ROW_W - 32);
    display.setTextColor(SH110X_WHITE);
    if (sel) {
      // punch the indicators out of the highlight so they stay readable
      display.fillRect(ROW_W - 27, y, 27, ROW_H - 1, SH110X_BLACK);
    }
    if (WiFi.encryptionType(idx) != WIFI_AUTH_OPEN) drawLock(ROW_W - 25, y + 1);
    drawSignalBars(ROW_W - 17, y + 1, WiFi.RSSI(idx));
  }
  drawScrollbar(wsCount, first);
  drawButtonLabels(G_UP, G_SELECT, G_DOWN);
}

static void wsMove(int d) {
  if (wsCount <= 0) return;
  wsSel = constrain(wsSel + d, 0, wsCount - 1);
}

static void wsSelect() {
  if (wsCount <= 0) return;
  snprintf(wifiSsid, sizeof(wifiSsid), "%s", WiFi.SSID(wsSel).c_str());
  bool open = (WiFi.encryptionType(wsSel) == WIFI_AUTH_OPEN);
  if (open) { wifiPass[0] = 0; navReplace(&AppWifiConnect); }
  else      wifiAskPassword();          // replaces the scan screen
}

static void wsButton(BtnId b, BtnEv e) {
  if (wsCount < 0) return;
  if (b == B_C) wsMove(-1);
  else if (b == B_A) wsMove(+1);
  else if (btnSelect(b) && e == EV_PRESS) {
    if (wsFailed) { wsFailed = false; wsRetries = 0; wsWaiting = false;
                    wsCount = -1; wsBeginScan(); }
    else wsSelect();
  }
}

static void wsKnob(int s) { if (s) wsMove(s > 0 ? +1 : -1); }

static const App AppWifiScan = {
  "Scan", nullptr, wsEnter, wsExit, wsTick, wsDraw, wsButton, wsKnob,
  nullptr, nullptr
};

/* ---- Wi-Fi info: current connection, then saved history ----------------- */
static int wiMode = 0;      // 0 current, 1 list, 2 detail
static int wiSel = 0, wiCount = 0;
static char wiSsid[33], wiPass[65];

static void wiEnter() {
  knobInputMode();
  wiSel = 0;
  wiCount = nvNetCount();
  /* Offline, the current-connection page has one thing to say and it is
   * "no". Opening straight into the history skips a screen whose only
   * purpose, in that state, is to be scrolled past. */
  wiMode = (!wifiOnline() && wiCount > 0) ? 1 : 0;
}

static void wiDrawKV(int y, const char *k, const char *v) {
  display.setCursor(0, y);
  display.print(k);
  printClipped(textW(k) + 6, y, v, CONTENT_W - textW(k) - 6);
}

static void wiDrawCurrent() {
  drawTitle("Current Connection");
  if (!wifiOnline()) {
    display.setCursor(0, 20);
    display.print("No Wi-Fi connected");
    display.setCursor(0, 34);
    display.printf("%d saved network%s", wiCount, wiCount == 1 ? "" : "s");
    if (wiCount > 0) {
      display.setCursor(0, 48);
      display.print("press v for list");
    }
    return;
  }
  char buf[32];
  wiDrawKV(14, "SSID", WiFi.SSID().c_str());
  wiDrawKV(23, "PASS", wifiPass[0] ? wifiPass : "(open)");
  wiDrawKV(32, "IP", WiFi.localIP().toString().c_str());
  snprintf(buf, sizeof(buf), "%d dBm  ch%d", (int)WiFi.RSSI(), (int)WiFi.channel());
  wiDrawKV(41, "RF", buf);
  wiDrawKV(50, "BSSID", WiFi.BSSIDstr().c_str());
}

static void wiDrawList() {
  drawTitle("Previous Connections");
  if (wiCount == 0) {
    display.setCursor(0, 28);
    display.print("None saved");
    return;
  }
  int first = (wiSel >= ROWS_VIS) ? wiSel - ROWS_VIS + 1 : 0;
  for (int i = 0; i < ROWS_VIS && first + i < wiCount; i++) {
    int idx = first + i;
    char s[33];
    s[0] = 0;
    nvNetGet(idx, s, sizeof(s), nullptr, 0);
    drawRow(ROW_TOP + i * ROW_H, idx == wiSel, false, s, nullptr, G_RIGHT);
  }
  drawScrollbar(wiCount, first);
}

static void wiDrawDetail() {
  drawTitle(wiSsid[0] ? wiSsid : "Saved Network");
  wiDrawKV(16, "SSID", wiSsid);
  wiDrawKV(26, "PASS", wiPass[0] ? wiPass : "(open)");

  const int bw = 54, bh = 14, bx = 0, by = 40;
  display.fillRoundRect(bx, by, bw, bh, 4, SH110X_WHITE);
  display.setTextColor(SH110X_BLACK);
  display.setCursor(bx + 8, by + 4);
  display.print("Connect");
  display.setTextColor(SH110X_WHITE);

  display.setCursor(0, 57);
  display.print("back to return");
}

static void wiDraw() {
  if (wiMode == 0) wiDrawCurrent();
  else if (wiMode == 1) wiDrawList();
  else wiDrawDetail();
  if (wiMode == 2) drawButtonLabels(G_NONE, G_SELECT, G_NONE);
  else drawButtonLabels(G_UP, G_SELECT, G_DOWN);
}

static void wiMove(int d) {
  if (wiMode == 2) return;
  if (wiMode == 0) {
    // scrolling down off the current-connection page enters the history list
    if (d > 0 && wiCount > 0) { wiMode = 1; wiSel = 0; }
    return;
  }
  int s = wiSel + d;
  if (s < 0) { wiMode = 0; return; }        // scrolling up returns to current
  wiSel = constrain(s, 0, max(0, wiCount - 1));
}

static void wiButton(BtnId b, BtnEv e) {
  if (b == B_C) wiMove(-1);
  else if (b == B_A) wiMove(+1);
  else if (btnSelect(b) && e == EV_PRESS && wiMode == 1 && wiCount > 0) {
    wiSsid[0] = wiPass[0] = 0;
    nvNetGet(wiSel, wiSsid, sizeof(wiSsid), wiPass, sizeof(wiPass));
    wiMode = 2;
  } else if (btnSelect(b) && e == EV_PRESS && wiMode == 2 && wiSsid[0]) {
    // Reconnect to a remembered network without retyping the password.
    snprintf(wifiSsid, sizeof(wifiSsid), "%s", wiSsid);
    snprintf(wifiPass, sizeof(wifiPass), "%s", wiPass);
    nvTouch();
    navReplace(&AppWifiConnect);
  }
}

static void wiKnob(int s) { if (s) wiMove(s > 0 ? +1 : -1); }

static bool wiBack() {
  if (wiMode == 2) { wiMode = 1; return true; }   // detail -> list
  return false;                                    // list/current -> leave app
}

static const App AppWifiInfo = {
  "Wi-Fi info", nullptr, wiEnter, nullptr, nullptr, wiDraw, wiButton, wiKnob,
  nullptr, wiBack
};

/* ---- Wi-Fi menu --------------------------------------------------------- */
static void wifiScanLink() { navPush(&AppWifiScan); }

/* The page behind this row opens on the current connection when there is one
 * and on the history when there is not, so the row is named for whichever it
 * will actually show. */
static const char *wifiInfoLabel() {
  return wifiOnline() ? "Wi-Fi info" : "Past connections";
}

static void mixerDemoStart();   // defined with the mixer app

static const CfgItem WIFI_ITEMS[] = {
  ITEM_ACT  ("Scan...",         wifiScanLink),
  ITEM_ACT  ("Manual input...", wifiManualStart),
  ITEM_LINKD("Wi-Fi info",      AppWifiInfo, wifiInfoLabel),
  /* Only present when the mixer sent us here for want of a network. Offering
   * the simulator from a Wi-Fi page in any other context would be a non
   * sequitur, so PageWifi.n is raised to 4 by wfEnter() and left at 3
   * otherwise. */
  ITEM_ACT  ("Demo Mode...",    mixerDemoStart),
};
static CfgPage PageWifi = { "Wi-Fi", WIFI_ITEMS, 3, 0, false, wifiTitle };
/* The only page whose length is decided at runtime: wfEnter() raises n to 4
 * to reveal the Demo row and drops it back to 3 otherwise, so the literal
 * above is the floor rather than the count. */
static_assert(sizeof(WIFI_ITEMS) / sizeof(WIFI_ITEMS[0]) == 4, "PageWifi row count");

static void wfEnter() {
  PageWifi.n = gWifiOfferDemo ? 4 : 3;
  cfgOpen(&PageWifi);
}

// When Wi-Fi was entered as a prerequisite for another app, backing out
// abandons that intent and returns home rather than to Settings.
static bool wfBack() {
  if (gWifiGateway) {
    gWifiGateway = false;
    gWifiOfferDemo = false;
    gAfterConnect = nullptr;
    navHome();
    return true;
  }
  return false;
}

static const App AppWifi = {
  "Wi-Fi", nullptr, wfEnter, nullptr, nullptr, cfgDraw, cfgButton, cfgKnob,
  nullptr, wfBack
};

/* ###########################################################################
 * #                    MIXER LINK  (OSC to the console)                     #
 * ######################################################################### */

/* /meters/0 returns 70 values:
 *   [ 0..31] 32 input channels     [32..39]  8 aux returns
 *   [40..47]  8 fx returns         [48..63] 16 bus masters
 *   [64..69]  6 matrixes
 * Main LR / mono and DCAs are absent, so those strips show no meter.
 * X32/M32 sends floats here; the X-Air family sends int16 dBFS*256 instead. */
struct Group {
  const char *label; const char *pathFmt;
  uint8_t count; int16_t meterBase;
  bool numbered, dcaStyle, enabled;
};

static const Group GROUPS[] = {
  { "CH",   "/ch/%02d",      32,  0, true,  false, true },
  { "AUX",  "/auxin/%02d",    8, 32, true,  false, true },
  { "FX",   "/fxrtn/%02d",    8, 40, true,  false, true },
  { "BUS",  "/bus/%02d",     16, 48, true,  false, true },
  { "MTX",  "/mtx/%02d",      6, 64, true,  false, true },
  { "MAIN", "/main/st",       1, -1, false, false, true },
  { "M/C",  "/main/m",        1, -1, false, false, true },
  { "DCA",  "/dca/%d",        8, -1, true,  true,  true },
};
static const int NUM_GROUPS = sizeof(GROUPS) / sizeof(GROUPS[0]);

static int   mlGroup = 0, mlNum = 1;
static char  mlFaderPath[40], mlNamePath[40];
static char  mlName[16] = "";
static float mlFader = 0.0f;
static uint32_t mlFaderSeq = 0;
static float    mlMeter = 0.0f, mlPeak = 0.0f;
static uint32_t mlPeakMs = 0;
static bool     mlMeterValid = false, mlMetersActive = false, mlUdpUp = false;
/* Demo drives the real Mixer UI from a local model of a console: the same
 * screen, strips, servo sync and de-oscillation, with the network stubbed.
 * It is intercepted at the three points where the app meets the wire --
 * udpTx, mlLinkOk and mlTick -- so the UI code needs no demo branches. */
static bool     mlDemo = false;
static float    mlDemoFader[NUM_GROUPS][32];
static bool     mlDemoInit = false;
static uint32_t mlDemoMs = 0;
static uint32_t mlLastRx = 0, mlLastXremote = 0, mlLastMeter = 0, mlLastResync = 0;
static uint8_t  mlRx[1024], mlTx[256];

static int oscPutStr(uint8_t *b, int off, const char *s) {
  int n = strlen(s);
  memcpy(b + off, s, n); off += n;
  do { b[off++] = 0; } while (off & 3);
  return off;
}
static int oscPutI32(uint8_t *b, int off, int32_t v) {
  b[off++] = (v >> 24) & 0xFF; b[off++] = (v >> 16) & 0xFF;
  b[off++] = (v >> 8) & 0xFF;  b[off++] = v & 0xFF;
  return off;
}
static int oscPutF32(uint8_t *b, int off, float f) {
  uint32_t v; memcpy(&v, &f, 4); return oscPutI32(b, off, (int32_t)v);
}
static int32_t oscI32BE(const uint8_t *b, int o) {
  return ((int32_t)b[o] << 24) | ((int32_t)b[o+1] << 16) |
         ((int32_t)b[o+2] << 8) | (int32_t)b[o+3];
}
static float oscF32BE(const uint8_t *b, int o) {
  uint32_t v = (uint32_t)oscI32BE(b, o); float f; memcpy(&f, &v, 4); return f;
}
static int32_t oscI32LE(const uint8_t *b, int o) {
  return (int32_t)((uint32_t)b[o] | ((uint32_t)b[o+1] << 8) |
                   ((uint32_t)b[o+2] << 16) | ((uint32_t)b[o+3] << 24));
}
static float oscF32LE(const uint8_t *b, int o) {
  uint32_t v = (uint32_t)oscI32LE(b, o); float f; memcpy(&f, &v, 4); return f;
}
static int16_t oscI16LE(const uint8_t *b, int o) {
  return (int16_t)((uint16_t)b[o] | ((uint16_t)b[o+1] << 8));
}

static IPAddress mixerIp() { return IPAddress((uint32_t)mxCfgIp); }
static bool mixerIpSet() { return mxCfgIp != 0; }

/* mxCfgIp and spCfgIp are the addresses for the network we are on right now,
 * adopted from the per-SSID table whenever that network changes. Both stay
 * NVS values of their own so the last pair survives a reboot into a Wi-Fi
 * outage rather than blanking for want of an SSID to look up. */
static char gNetSsid[33] = "";

/* Carry addresses configured before this table existed into the table, once,
 * at boot.
 *
 * It has to happen here rather than on the first connect. The first adopt
 * would otherwise find no entry for that network, set the live address to
 * zero and flush it -- destroying the only copy of an address the user had
 * working.
 *
 * Neither address recorded which network it belonged to, so each gets the
 * best guess available and the Networks page shows where it landed. For the
 * console that is the most recently saved network; for the soundbar it is the
 * network the device is configured to join, since a soundbar lives where the
 * device lives. A wrong guess is one edit to fix. A deleted address is not.
 *
 * mnVer tracks which of the two has been done, because the table is no longer
 * empty by the time the second one is added. */
static void netProfileMigrate() {
  prefs.begin("knobos", true);
  int ver = prefs.getInt("mnVer", 0);
  prefs.end();
  if (ver >= 2) return;

  if (ver < 1 && mxCfgIp && nvNetCount() && !nvNetIpsCount()) {
    char s[33];
    s[0] = 0;
    nvNetGet(0, s, sizeof(s), nullptr, 0);
    if (s[0]) nvNetSetMixer(s, mxCfgIp);
  }
  if (spCfgIp) {
    char s[33];
    s[0] = 0;
    snprintf(s, sizeof(s), "%s", wifiSsid);
    if (!s[0] && nvNetCount()) nvNetGet(0, s, sizeof(s), nullptr, 0);
    if (s[0]) nvNetSetSpk(s, spCfgIp);
  }

  prefs.begin("knobos", false);
  prefs.putInt("mnVer", 2);
  prefs.end();
}

// Defined with the speaker module, which owns the state it resets.
static void spkNoteAddressChange();

/* Adopting a network replaces BOTH live addresses, including with zero. Zero
 * is the whole point: it is what lets the speaker app know at once that there
 * is nothing to talk to here, rather than spending six seconds of silence
 * finding out. */
static void netProfileAdopt(const char *ssid) {
  snprintf(gNetSsid, sizeof(gNetSsid), "%s", ssid ? ssid : "");
  NetIps v = { 0, 0 };
  nvNetIpsFind(gNetSsid, &v);
  bool changed = false;
  if (v.mixer != mxCfgIp) {
    mxCfgIp = v.mixer;
    mlUdpUp = false;        // any socket open for the old address is stale
    changed = true;
  }
  if (v.spk != spCfgIp) {
    spCfgIp = v.spk;
    spkNoteAddressChange();
    changed = true;
  }
  if (changed) nvTouch();
}

/* Polled rather than hooked to the connect path: a reconnect, a roam onto a
 * different SSID and the first association after boot all arrive by different
 * routes, and all three have to be caught.
 *
 * Once a second, not every pass: WiFi.SSID() builds a String, and doing that
 * a few thousand times a second is exactly the kind of heap churn this board
 * cannot afford. */
static uint32_t gNetMs = 0;

static void netProfileService() {
  if (!wifiOnline() || !elapsed(gNetMs, 1000)) return;
  gNetMs = millis();
  String cur = WiFi.SSID();
  if (cur.length() && strcmp(cur.c_str(), gNetSsid)) netProfileAdopt(cur.c_str());
}

static void udpTx(int len) {
  if (mlDemo) return;                    // nothing goes on the wire in demo
  if (!mlUdpUp || !mixerIpSet()) return;
  udp.beginPacket(mixerIp(), (uint16_t)mxCfgPort);
  udp.write(mlTx, len);
  udp.endPacket();
}
static void oscQuery(const char *a) {
  int o = oscPutStr(mlTx, 0, a); o = oscPutStr(mlTx, o, ","); udpTx(o);
}
static void oscFloat(const char *a, float f) {
  int o = oscPutStr(mlTx, 0, a); o = oscPutStr(mlTx, o, ",f");
  o = oscPutF32(mlTx, o, f); udpTx(o);
}
static void oscXremote() { udpTx(oscPutStr(mlTx, 0, "/xremote")); }
static void oscMeterSub() {
  int o = oscPutStr(mlTx, 0, "/meters"); o = oscPutStr(mlTx, o, ",si");
  o = oscPutStr(mlTx, o, "/meters/0"); o = oscPutI32(mlTx, o, mxCfgMeterRate);
  udpTx(o);
}

static void mlBuildPaths() {
  const Group &g = GROUPS[mlGroup];
  char base[32];
  if (g.numbered) snprintf(base, sizeof(base), g.pathFmt, mlNum);
  else            snprintf(base, sizeof(base), "%s", g.pathFmt);
  snprintf(mlFaderPath, sizeof(mlFaderPath), "%s%s", base,
           g.dcaStyle ? "/fader" : "/mix/fader");
  snprintf(mlNamePath, sizeof(mlNamePath), "%s/config/name", base);
}
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
void loop() {
  knobUpdate();
  netProfileService();
  mlTick();
  /* Skip polling entirely while the wake press is still held. Previously the
   * guard was evaluated and then ignored, so buttonsPoll() saw the button
   * down and raised a press anyway -- and with a repeat delay set, holding it
   * a moment longer produced repeats too. */
  if (!wakeGuardBlocking()) buttonsPoll();

  if (cur() && cur()->onKnob) {
    int s = knobSteps();
    if (s) { cur()->onKnob(s); batNoteActivity(); }
  }
  batSupervise();

  npTouched = false;
  if (cur() && cur()->tick) cur()->tick();
  // Nothing claimed the ring this pass, so it belongs to no screen: dark.
  if (cur() != &AppNpTest && (!npTouched || !npEnable)) npClear();

  if (gNavDirty) { gNavDirty = false; navSaveNow(); }
  nvService();

  if (elapsed(gLastDraw, DISPLAY_MS)) {
    gLastDraw = millis();
    gFrame++;
    display.clearDisplay();
    display.setTextSize(1);
    display.setTextColor(SH110X_WHITE);
    CONTENT_W = CONTENT_W_NARROW;      // wide screens opt in from their draw()
    if (cur() && cur()->draw) cur()->draw();
    display.display();
  }
}


/* The full per-version changelog lives in CHANGELOG.md.
 *
 * It is written as reasoning rather than as a list of edits: what each
 * change was for, and where a wrong hypothesis was corrected. That is the
 * best guide to the parts of this file that look arbitrary. */
