penguinmoose/knobOS/(commit log)

2026-09-01 v10.0 OSC IP now per-network, demo mode on mixer wifi screen, fix sleep, auto mixer backlight
    [knob_os.ino]
2026-09-01 Minor readme change battery details
2026-09-01 v10.1: knob seeks when there is no speaker, quiet delay for auto backlight
    With no speaker to send it to, the volume bar was a control that did
    nothing, and the knob drove it anyway. Both now switch to the playhead: a
    detent seeks by Knob Rate A, or Knob Rate B while the shaft button is
    held, which is the same two-rate arrangement the mixer fader uses.
    Acceleration is opt-in per rate. Spotify's seek does not interrupt
    playback, so the track keeps running throughout.
    The sweep is local and only the resting position is sent, 400ms after the
    knob stops. Sending one seek per detent would both flood the API and lag
    behind the knob, since a round trip is a few hundred milliseconds.
    In seek mode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
2026-09-01 v10.2: Auto knob mode follows speaker reachability, not a stored address
    Away from home the knob kept offering volume for a speaker that was not
    there. v10.1 asked whether an address was stored, and the answer was yes:
    the speaker address is global, so leaving the house carries it along and
    the app was certain a speaker was present in a room that had none. The
    volume bar moved and changed nothing.
    Auto now asks whether a speaker is reachable. spkLinkOk() alone is far
    too eager to answer no, since spkOnline drops on a single refused poll
    and one lost packet would rebuild the whole layout, so the test is six
    seconds of sustained silence. The same timer covers entry, when the first
    poll is sti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
2026-09-01 v10.3: album line in the no-speaker layout, drop the status line
    The status line under the progress bar spent its life announcing a speaker
    that was not there, which the absent volume bar already says. The row is
    worth more as information about the music, so the artist moves down a line
    and the album takes the gap under the title: title, album, artist,
    progress.
    The album name has to be found backwards. Reading forward from `album`
    lands on the album ARTIST's name, since inside the album object the keys
    run album_type, artists, ..., name. The album's own name is the last
    "name" between the `album` key and the track's own `artists`, bounded at
    the front by that key so an item with no album a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
2026-09-01 v10.4: per-network soundbar address, mode selection, title wrapping
    The soundbar address is now per network, as the console address has been
    since v10.0. It was the last thing the device carried between rooms as
    though it applied everywhere: away from home the speaker app spent six
    seconds of silence proving there was nothing to talk to, offering a volume
    bar the whole time. With no address for the network there is nothing to
    prove, and the app is in Spotify mode from the first frame.
    Both addresses live in one per-SSID table now, and adopting a network
    replaces both, including with zero. Zero is the point: it turns "no
    speaker here" from something discovered into something already known.
    S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
    [knob_os.ino]
2026-09-02 v10.5: hold the shaft and turn to seek with a speaker connected
    Seeking was only reachable when nothing else wanted the knob. Now the
    shaft button borrows it, the same gesture the mixer uses to reach its
    second fader rate.
    Hold Seek is its own rate rather than a reuse of Knob Rate B. Rate B is
    the coarse partner to a fine Rate A and the two are chosen together; this
    is the only seek rate available in volume mode, so it wants to sit
    between them rather than being whichever of the two Rate B happens to be.
    Default 15s per detent against 5s and 30s. Acceleration follows Rate B's
    opt-in, since both are the shaft-held rate and only the mode differs. Off
    returns the shaft button to play/pause alo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
2026-09-02 v10.6: NeoPixel start failure is a stranded library mutex; debounce presses
    The ring failing to start on some boots and coming right after a reset is
    a stuck semaphore inside Adafruit_NeoPixel, not a wiring or allocation
    fault. Its ESP-IDF 5 backend takes a mutex around every show() and, on one
    path -- rmtInit() failing -- returns without giving it back. Every later
    show() then times out on it and does nothing, silently, for the rest of
    the session. A second, quieter one: the mutex is created once from a
    global constructor and never retried.
    Both are routed around rather than waited on. npBegin() calls espInit()
    again in case the constructor's mutex never appeared, and claims the RMT
    channe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
    [knob_os.ino]
2026-09-05 Replace device image with labeled version
    Updated image in Hardware section to labeled version.
